odeh24/SRIP-ToT/touch_glove.png

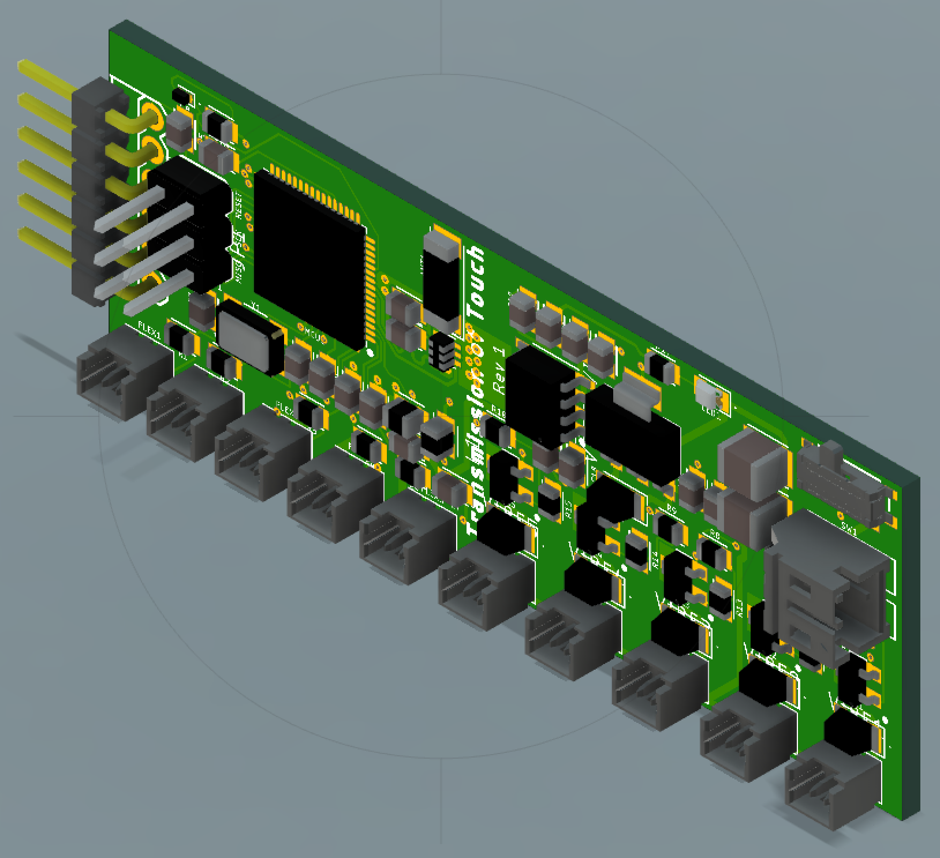
touch_glove.png
