odeh24/SRIP-ToT/mcad/TouchGlove v2.step

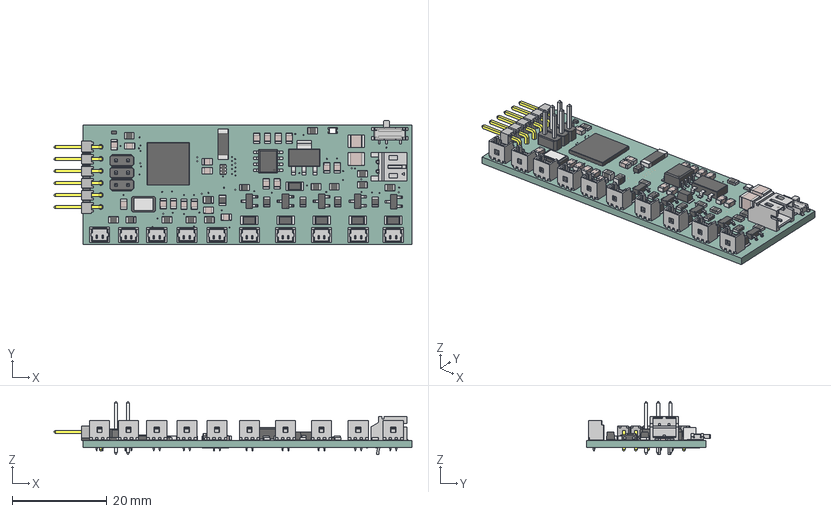
[picture p2: CAD file, 2018-08-09]
mcad/TouchGlove v2.step
75.6 x 26.2 x 11.3 mm
Board
2.45GHz
Dual TH withbump format x 3
50/100
1uF/25V x 19
100uF/10V x 2
1A/50V x 6
150mA/75V
10K x 5
_TSW-106-08-T-S-RA_body
_T-1S6-08-TSW-1-08-6-RA-S
base
cover
housing
marking x 2
base_2
7.4V
ATMEGA128RFA1
SI2302CDS 2.9A/20V x 5
2PT_GND_TIE x 2
300mA/4V
1A/3.3V
TL1963A-33 1.5A/3.3V
16 MHz
Molex VERT 1.25mm pitch x 5
PIB_LOGO_10MM
10uH x 2
