odeh24/SRIP-ToT/Eagle Schematics/RobotArm.brd

## EAGLE design Eagle Schematics/RobotArm.brd (2018-08-07)

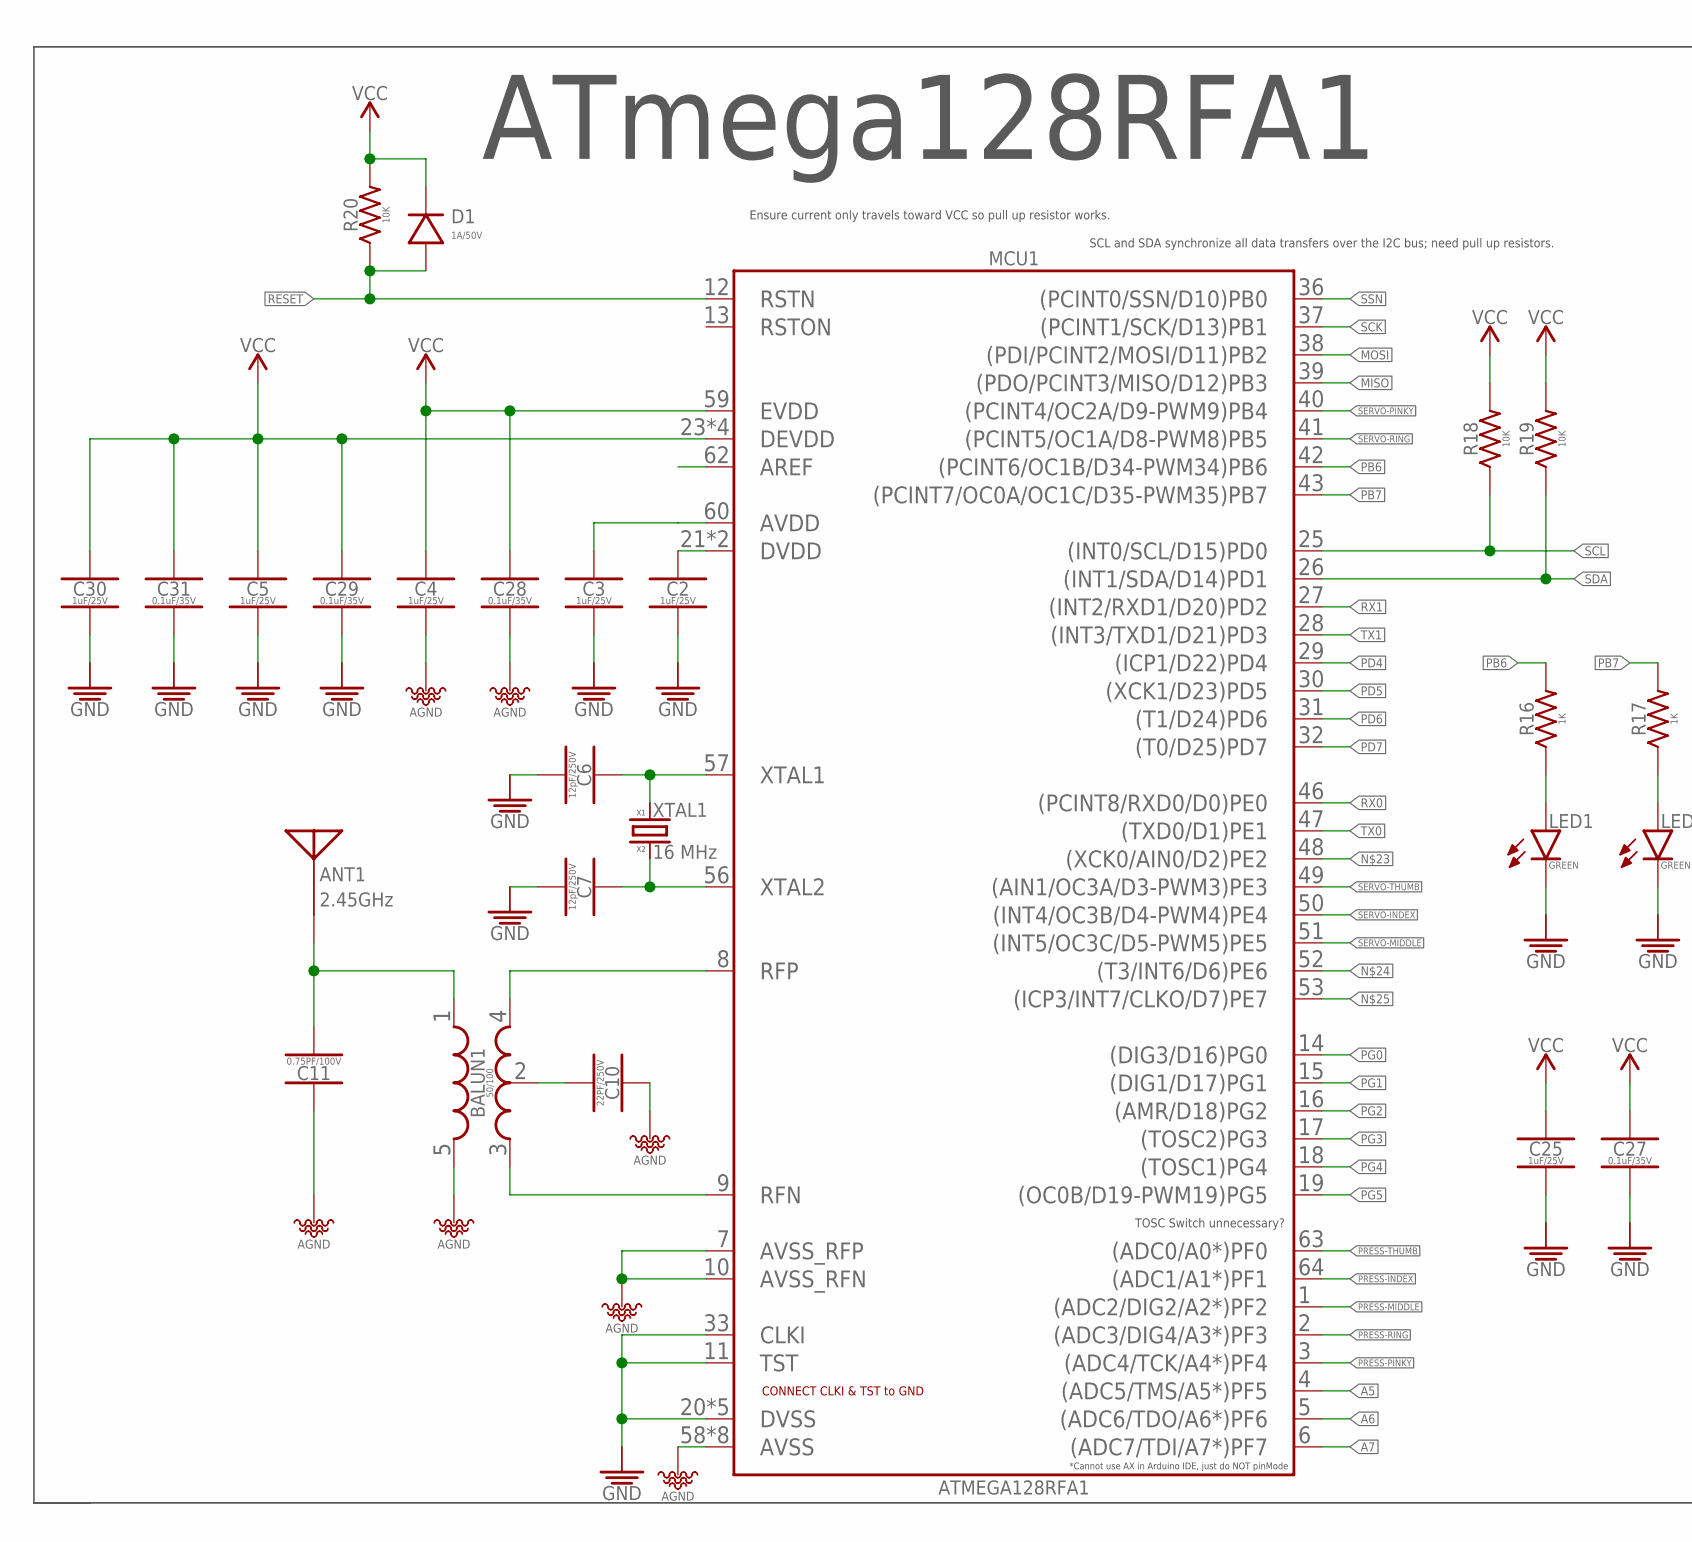
[picture p3: schematic RobotArm.sch, part in row 1, column 1]

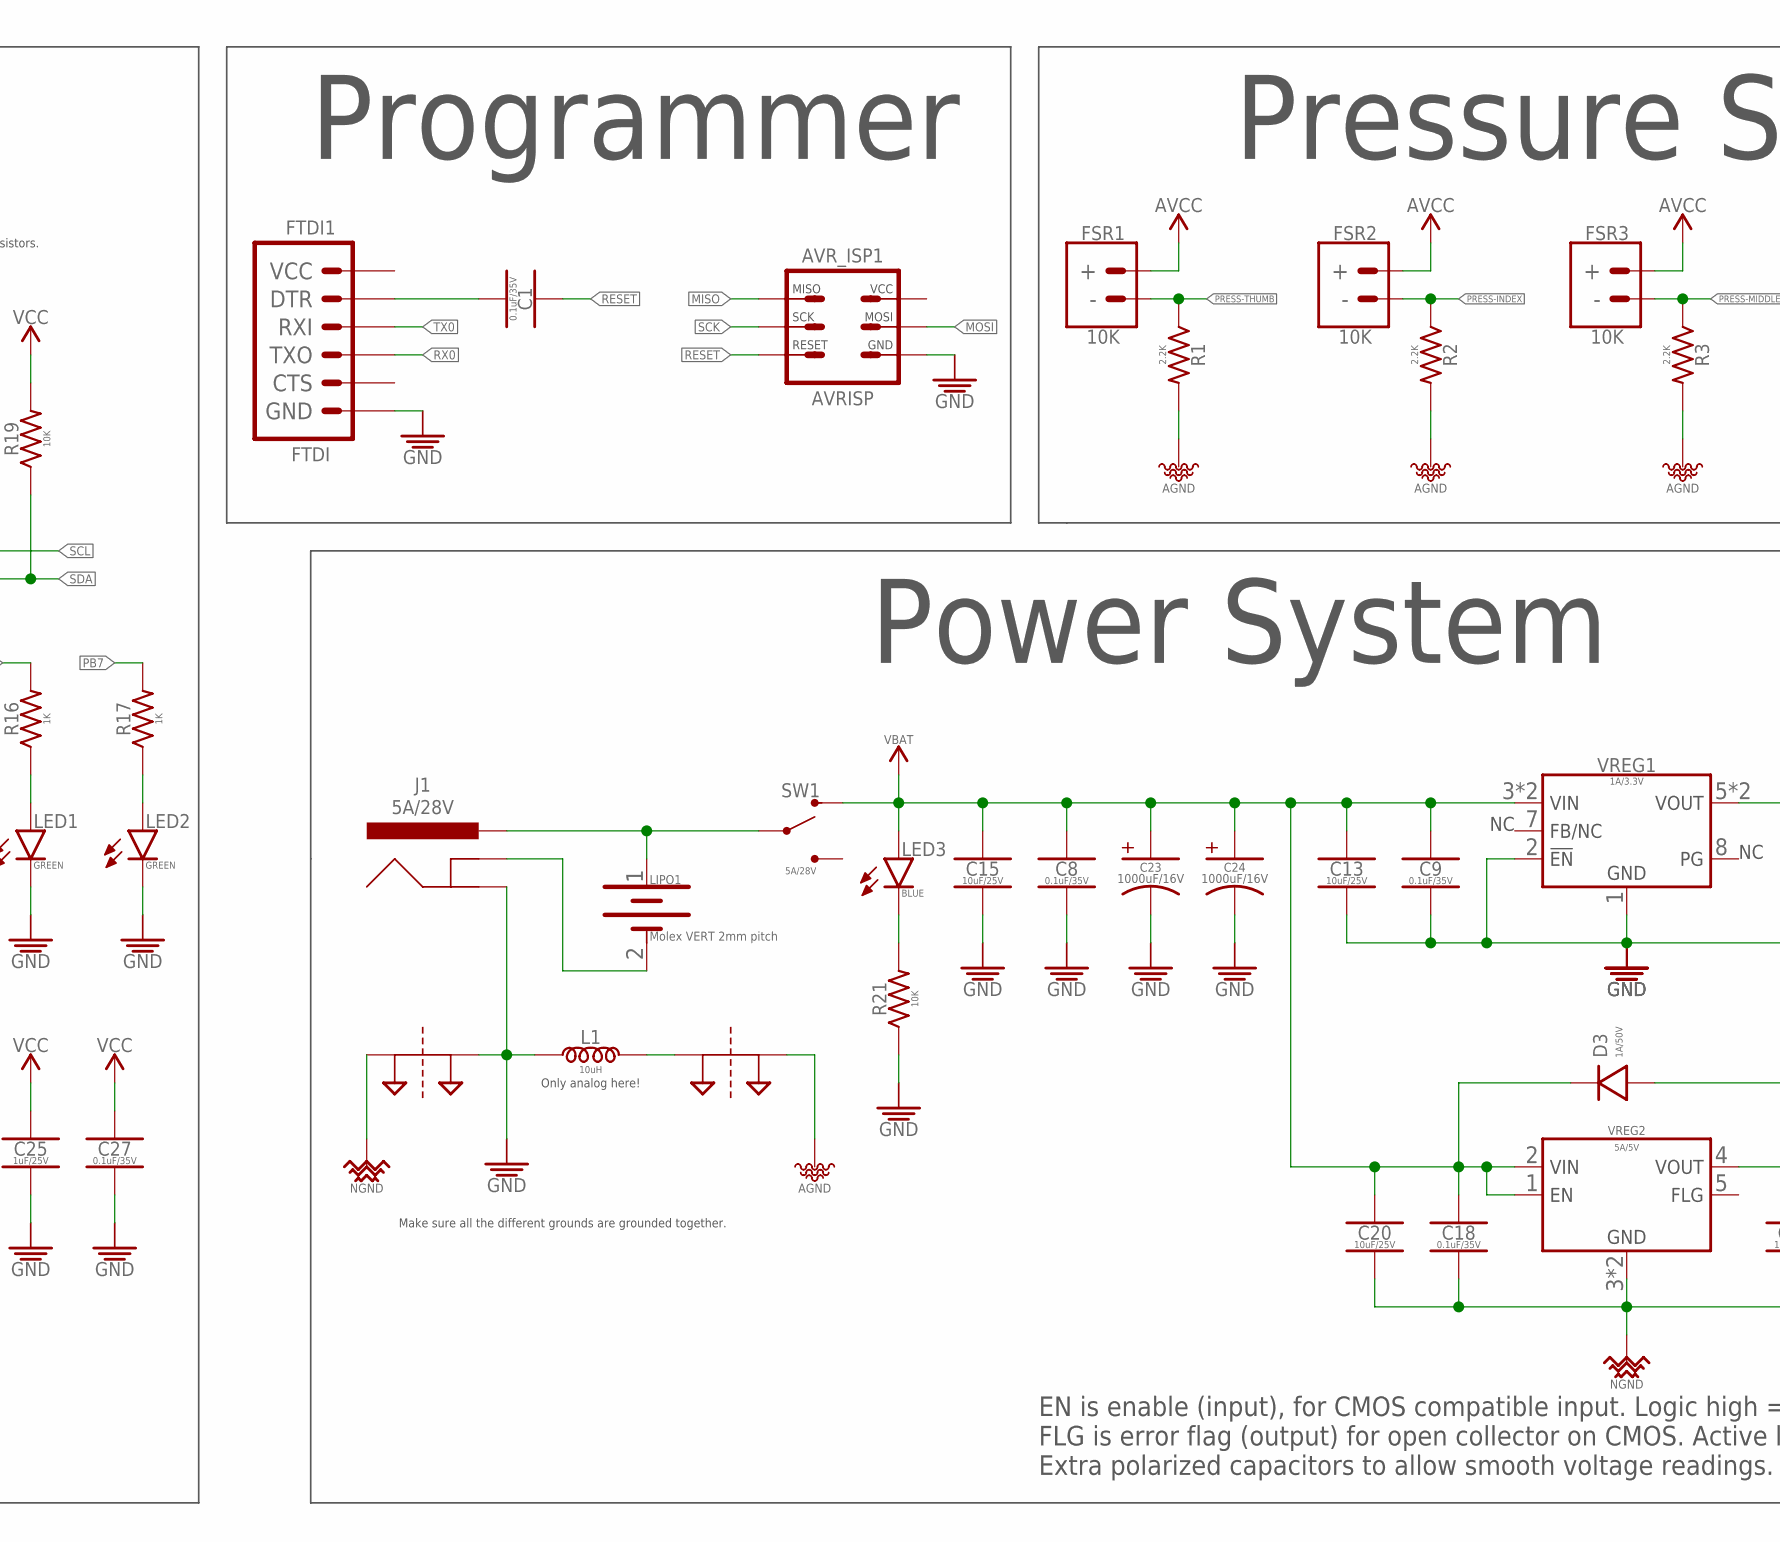
[picture p4: schematic RobotArm.sch, part in row 1, column 2]

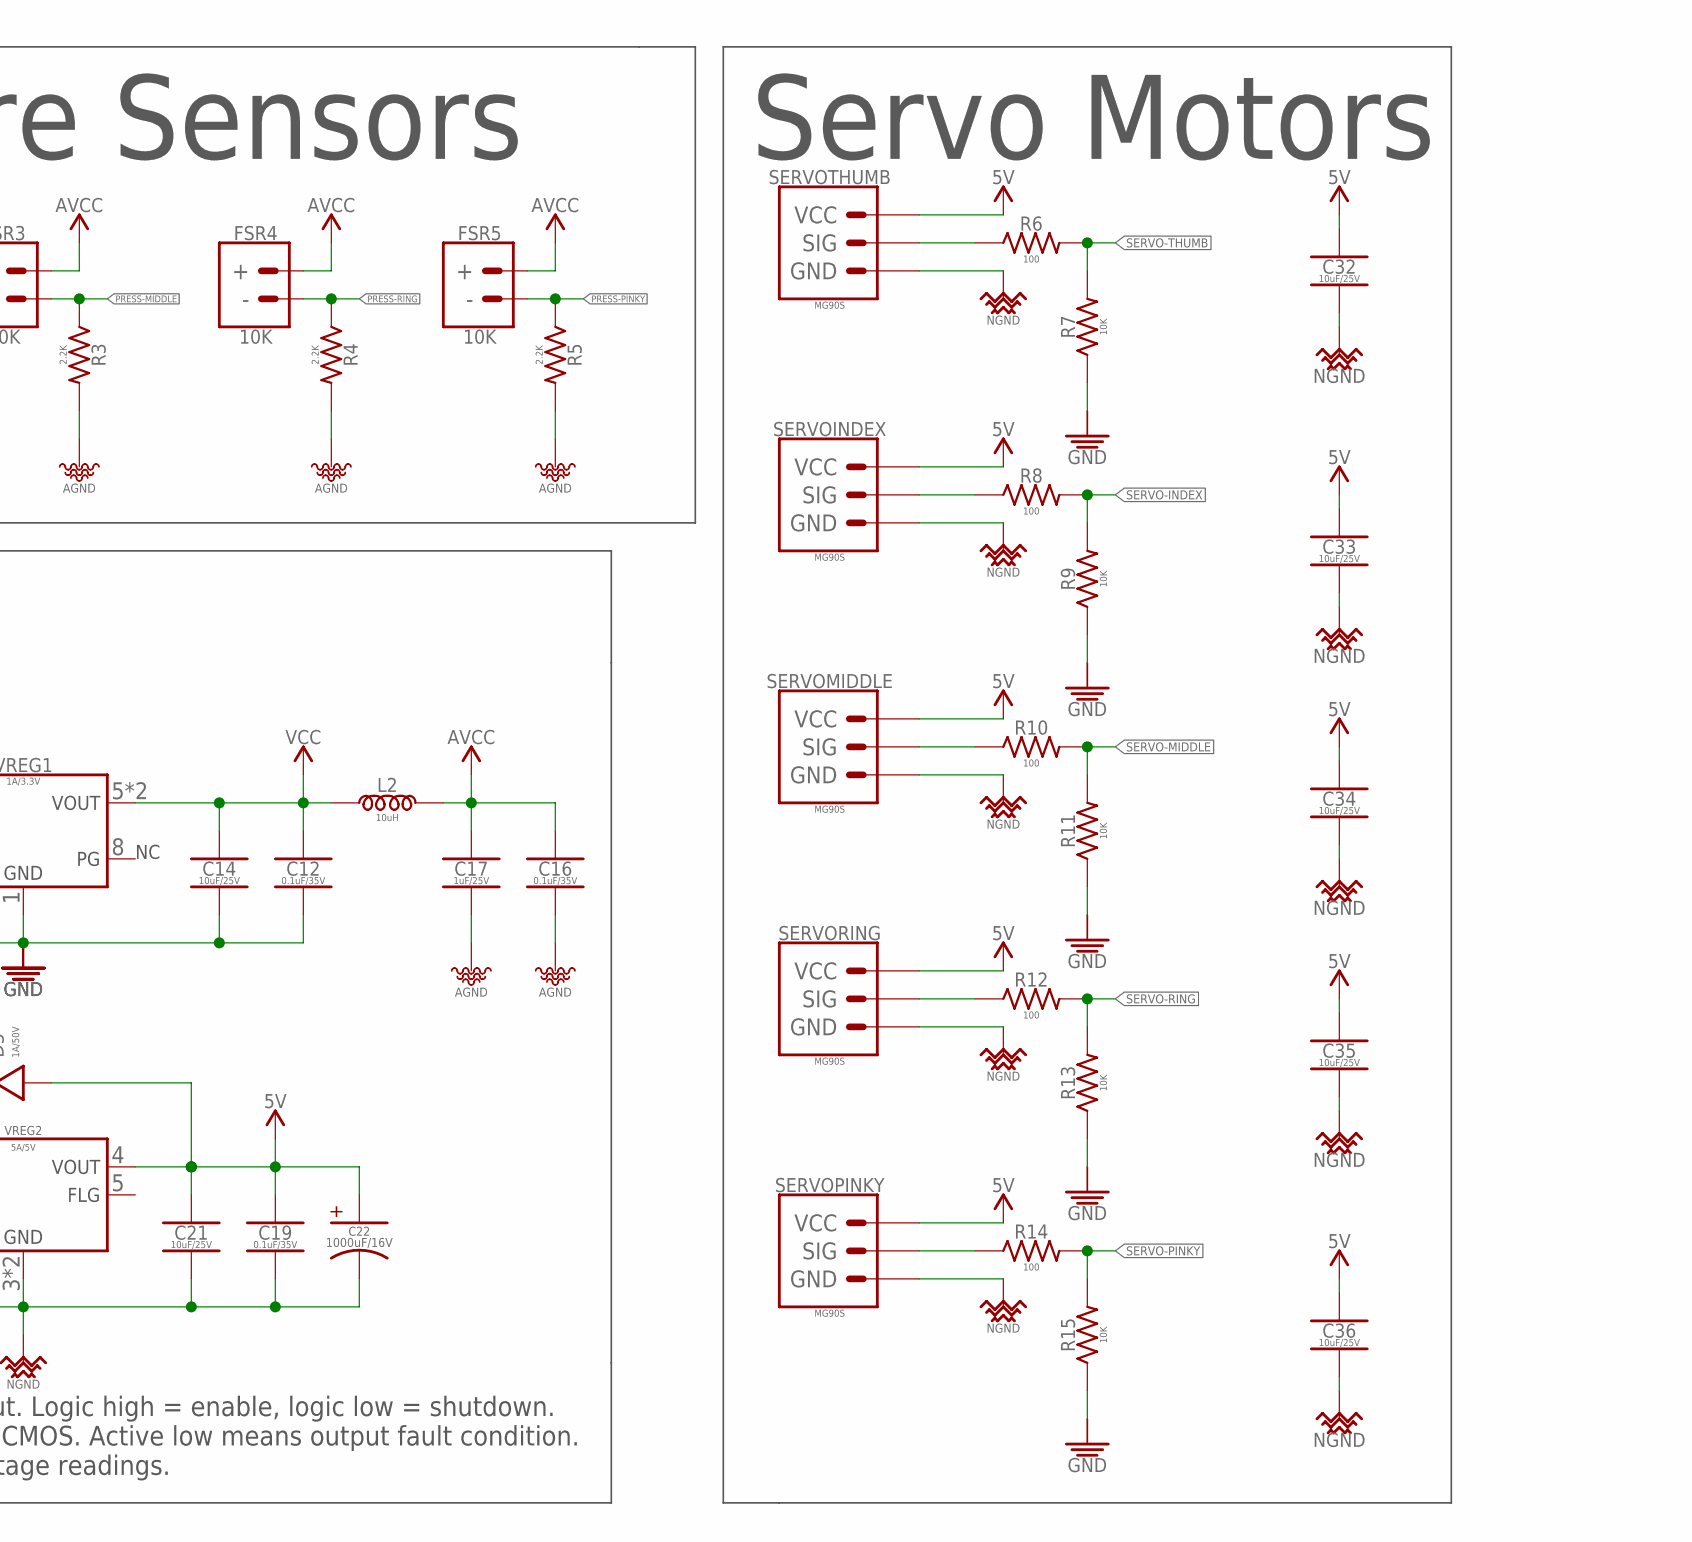
[picture p5: schematic RobotArm.sch, part in row 1, column 3]

Parts:
ANT1: 2.45GHz; ANTC6522X100
AVR_ISP1: AVRISP; 2X3-NS
BALUN1: 50/100; RESCAXE65P200X125X95-6
C1, C8, C9, C12, C16, C18, C19, C27, C28, C29, C31: 0.1uF/35V; CAPC2012X95_SMD-0805
C2, C3, C4, C5, C17, C25, C30: 1uF/25V; CAPC2012X95_SMD-0805
C6, C7: 12pF/250V; CAPC2012X95_SMD-0805
C10: 22PF/250V; _CER_SMD-805
C11: 0.75PF/100V; _CER_SMD-805
C13, C14, C15, C20, C21, C32, C33, C34, C35, C36: 10uF/25V; CAPC2012X95_SMD-0805
C22, C23, C24: 1000uF/16V; _AE_PTH_DIA8-LS3.5-H21.50
D1, D3: 1A/50V; SODFL3516X170
FSR1, FSR2, FSR3, FSR4, FSR5: 10K; _MOLEX-0530470210_VERT_PITCH-1.25MM
FTDI1: FTDI; FTDI_BASIC-6PIN-MALE-RA
J1: 5A/28V; POWER_JACK_PTH_ID2.1MM-OD5.5MM
L1, L2: 10uH; _SMD-805
LED1, LED2: GREEN; LEDC2012X120_LED-0805
LED3: BLUE; LEDC2012X120_LED-0805
LIPO1: Molex VERT 2mm pitch; _MOLEX-89400_VERT_PITCH-2MM
MCU1: ATMEGA128RFA1; QFN50P900X900X90-64
NET_BRIDGE1, NET_BRIDGE2: 2PT_GND_TIE
R1, R2, R3, R4, R5: 2.2K; RESC2012X60_SMD-0805
R6, R8, R10, R12, R14: 100; RESC2012X60_SMD-0805
R7, R9, R11, R13, R15, R18, R19, R20, R21: 10K; RESC2012X60_SMD-0805
R16, R17: 1K; RESC2012X60_SMD-0805
SERVOINDEX: MG90S; 1X03-VERT-MALE
SERVOMIDDLE: MG90S; 1X03-VERT-MALE
SERVOPINKY: MG90S; 1X03-VERT-MALE
SERVORING: MG90S; 1X03-VERT-MALE
SERVOTHUMB: MG90S; 1X03-VERT-MALE
SW1: 5A/28V; SW_TOGGLE_SPDT_5A-28V_13L-7W
VREG1: 1A/3.3V; SOIC127P600X265-8
VREG2: 5A/5V; TO170P1363X457-6
XTAL1: 16 MHz; OSCCC500X320X110

Connections:
5V: C19.1, C21.1, C22.+ (A), C32.1, C33.1, C34.1, C35.1, C36.1, D3.A, SERVOINDEX.VCC, SERVOMIDDLE.VCC, SERVOPINKY.VCC, SERVORING.VCC, SERVOTHUMB.VCC, VREG2.4 (VOUT)
+: J1.PWR, LIPO1.1 (+), SW1.P
-: J1.GND@1 (GND), LIPO1.2 (-)
A5: MCU1.4 ((ADC5/TMS/A5*)PF5)
A6: MCU1.5 ((ADC6/TDO/A6*)PF6)
A7: MCU1.6 ((ADC7/TDI/A7*)PF7)
AGND: BALUN1.5 (GND), C4.2, C10.1, C11.1, C16.2, C17.2, C28.2, MCU1.7 (AVSS_RFP), MCU1.10 (AVSS_RFN), MCU1.58 (AVSS), MCU1.61 (AVSS), MCU1.EP (AVSS), MCU1.P$1 (AVSS), MCU1.P$2 (AVSS), MCU1.P$3 (AVSS), MCU1.P$4 (AVSS), MCU1.P$5 (AVSS), NET_BRIDGE2.P$2, R1.2, R2.2, R3.2, R4.2, R5.2
AVCC: C16.1, C17.1, L2.2
GND: AVR_ISP1.GND, C2.2, C3.2, C5.2, C6.2, C7.2, C8.2, C9.2, C12.2, C13.2, C14.2, C15.2, C23.- (K), C24.- (K), C25.2, C27.2, C29.2, C30.2, C31.2, FTDI1.GND, J1.GND@2 (GND), L1.1, LED1.K, LED2.K, MCU1.11 (TST), MCU1.20 (DVSS), MCU1.24 (DVSS), MCU1.33 (CLKI), MCU1.35 (DVSS), MCU1.45 (DVSS), MCU1.55 (DVSS), NET_BRIDGE1.P$2, R7.1, R9.1, R11.1, R13.1, R15.1, R21.1, VREG1.1 (GND), VREG1.2 (!EN)
MISO: AVR_ISP1.MISO, MCU1.39 ((PDO/PCINT3/MISO/D12)PB3)
MOSI: AVR_ISP1.MOSI, MCU1.38 ((PDI/PCINT2/MOSI/D11)PB2)
unnamed: R6.1, SERVOTHUMB.SIG
unnamed: LED1.A, R16.1
unnamed: R8.1, SERVOINDEX.SIG
unnamed: R10.1, SERVOMIDDLE.SIG
unnamed: R12.1, SERVORING.SIG
unnamed: R14.1, SERVOPINKY.SIG
unnamed: LED2.A, R17.1
unnamed: C6.1, MCU1.57 (XTAL1), XTAL1.1 (XTAL1)
unnamed: C7.1, MCU1.56 (XTAL2), XTAL1.3 (XTAL2)
unnamed: C1.2, FTDI1.DTR
unnamed: BALUN1.4 (OUT2), MCU1.8 (RFP)
unnamed: BALUN1.3 (OUT1), MCU1.9 (RFN)
unnamed: C3.1, MCU1.60 (AVDD)
unnamed: C2.1, MCU1.21 (DVDD), MCU1.22 (DVDD)
unnamed: BALUN1.2 (GND), C10.2
unnamed: ANT1.1, BALUN1.1 (IN), C11.2
unnamed: L1.2, NET_BRIDGE2.P$1
unnamed: LED3.K, R21.2
NGND: C18.2, C19.2, C20.2, C21.2, C22.- (K), C32.2, C33.2, C34.2, C35.2, C36.2, NET_BRIDGE1.P$1, SERVOINDEX.GND, SERVOMIDDLE.GND, SERVOPINKY.GND, SERVORING.GND, SERVOTHUMB.GND, VREG2.3 (GND), VREG2.6 (GND)
PB6: MCU1.42 ((PCINT6/OC1B/D34-PWM34)PB6), R16.2
PB7: MCU1.43 ((PCINT7/OC0A/OC1C/D35-PWM35)PB7), R17.2
PD4: MCU1.29 ((ICP1/D22)PD4)
PD5: MCU1.30 ((XCK1/D23)PD5)
PD6: MCU1.31 ((T1/D24)PD6)
PD7: MCU1.32 ((T0/D25)PD7)
PG0: MCU1.14 ((DIG3/D16)PG0)
PG1: MCU1.15 ((DIG1/D17)PG1)
PG2: MCU1.16 ((AMR/D18)PG2)
PG3: MCU1.17 ((TOSC2)PG3)
PG4: MCU1.18 ((TOSC1)PG4)
PG5: MCU1.19 ((OC0B/D19-PWM19)PG5)
PRESS-INDEX: FSR2.2 (-), MCU1.64 ((ADC1/A1*)PF1), R2.1
PRESS-MIDDLE: FSR3.2 (-), MCU1.1 ((ADC2/DIG2/A2*)PF2), R3.1
PRESS-PINKY: FSR5.2 (-), MCU1.3 ((ADC4/TCK/A4*)PF4), R5.1
PRESS-RING: FSR4.2 (-), MCU1.2 ((ADC3/DIG4/A3*)PF3), R4.1
PRESS-THUMB: FSR1.2 (-), MCU1.63 ((ADC0/A0*)PF0), R1.1
RESET: AVR_ISP1.RESET, C1.1, D1.A, MCU1.12 (RSTN), R20.1
RX0: FTDI1.TXO, MCU1.46 ((PCINT8/RXD0/D0)PE0)
RX1: MCU1.27 ((INT2/RXD1/D20)PD2)
SCK: AVR_ISP1.SCK, MCU1.37 ((PCINT1/SCK/D13)PB1)
SCL: MCU1.25 ((INT0/SCL/D15)PD0), R18.1
SDA: MCU1.26 ((INT1/SDA/D14)PD1), R19.1
SERVO-INDEX: MCU1.50 ((INT4/OC3B/D4-PWM4)PE4), R8.2, R9.2
SERVO-MIDDLE: MCU1.51 ((INT5/OC3C/D5-PWM5)PE5), R10.2, R11.2
SERVO-PINKY: MCU1.40 ((PCINT4/OC2A/D9-PWM9)PB4), R14.2, R15.2
SERVO-RING: MCU1.41 ((PCINT5/OC1A/D8-PWM8)PB5), R12.2, R13.2
SERVO-THUMB: MCU1.49 ((AIN1/OC3A/D3-PWM3)PE3), R6.2, R7.2
SSN: MCU1.36 ((PCINT0/SSN/D10)PB0)
TX0: FTDI1.RXI, MCU1.47 ((TXD0/D1)PE1)
TX1: MCU1.28 ((INT3/TXD1/D21)PD3)
VBAT: C8.1, C9.1, C13.1, C15.1, C18.1, C20.1, C23.+ (A), C24.+ (A), D3.K, LED3.A, SW1.S1, VREG1.3 (VIN), VREG1.4 (VIN), VREG2.1 (EN), VREG2.2 (VIN)
VCC: C4.1, C5.1, C12.1, C14.1, C25.1, C27.1, C28.1, C29.1, C30.1, C31.1, D1.K, FSR1.1 (+), FSR2.1 (+), FSR3.1 (+), FSR4.1 (+), FSR5.1 (+), L2.1, MCU1.23 (DEVDD), MCU1.34 (DEVDD), MCU1.44 (DEVDD), MCU1.54 (DEVDD), MCU1.59 (EVDD), R18.2, R19.2, R20.2, VREG1.5 (VOUT), VREG1.6 (VOUT)

Notes on the sheet:
ATmega128RFA1
Pressure Sensors
Power System
Programmer
Servo Motors
SCL and SDA synchronize all data transfers over the I2C bus; need pull up resistors.
TOSC Switch unnecessary?
Ensure current only travels toward VCC so pull up resistor works.
Make sure all the different grounds are grounded together.
Only analog here!
EN is enable (input), for CMOS compatible input. Logic high = enable, logic low = shutdown. FLG is error flag (output) for open collector on CMOS. Active low means output fault condition. Extra polarized capacitors to allow smooth voltage readings.

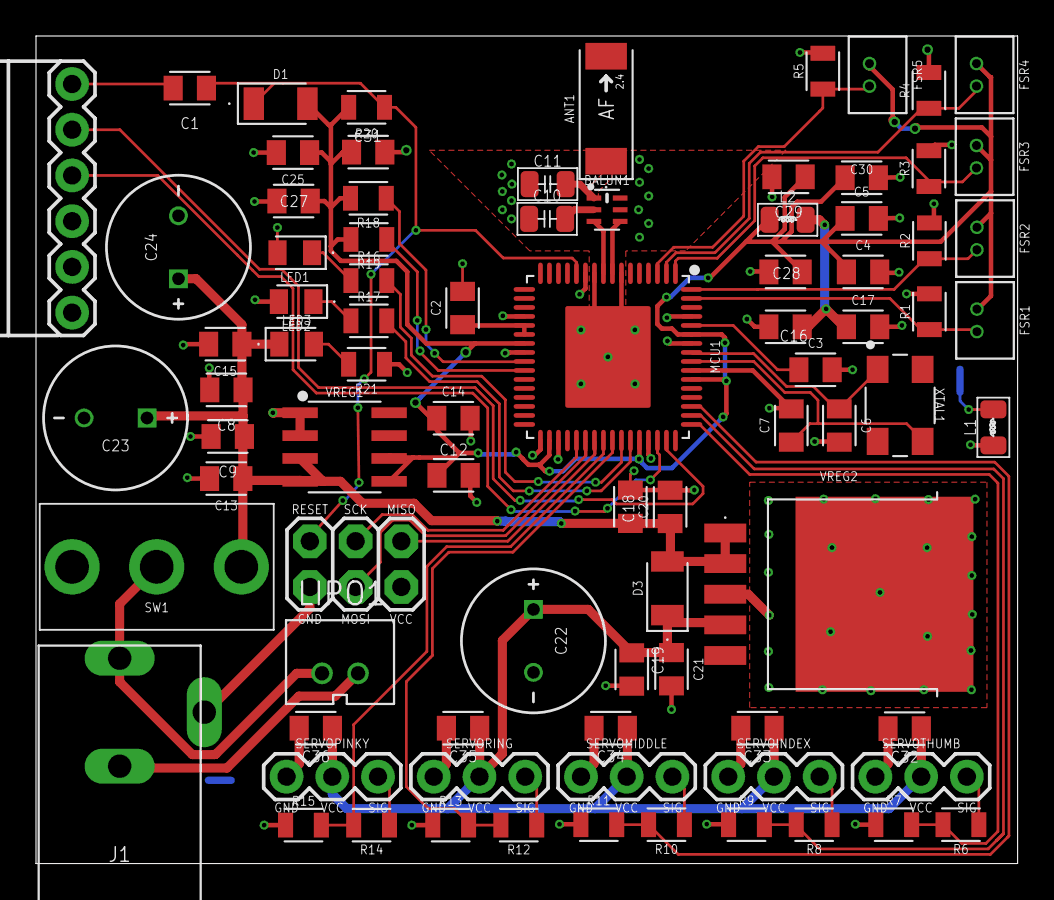
[picture p6: board RobotArm.brd from above]

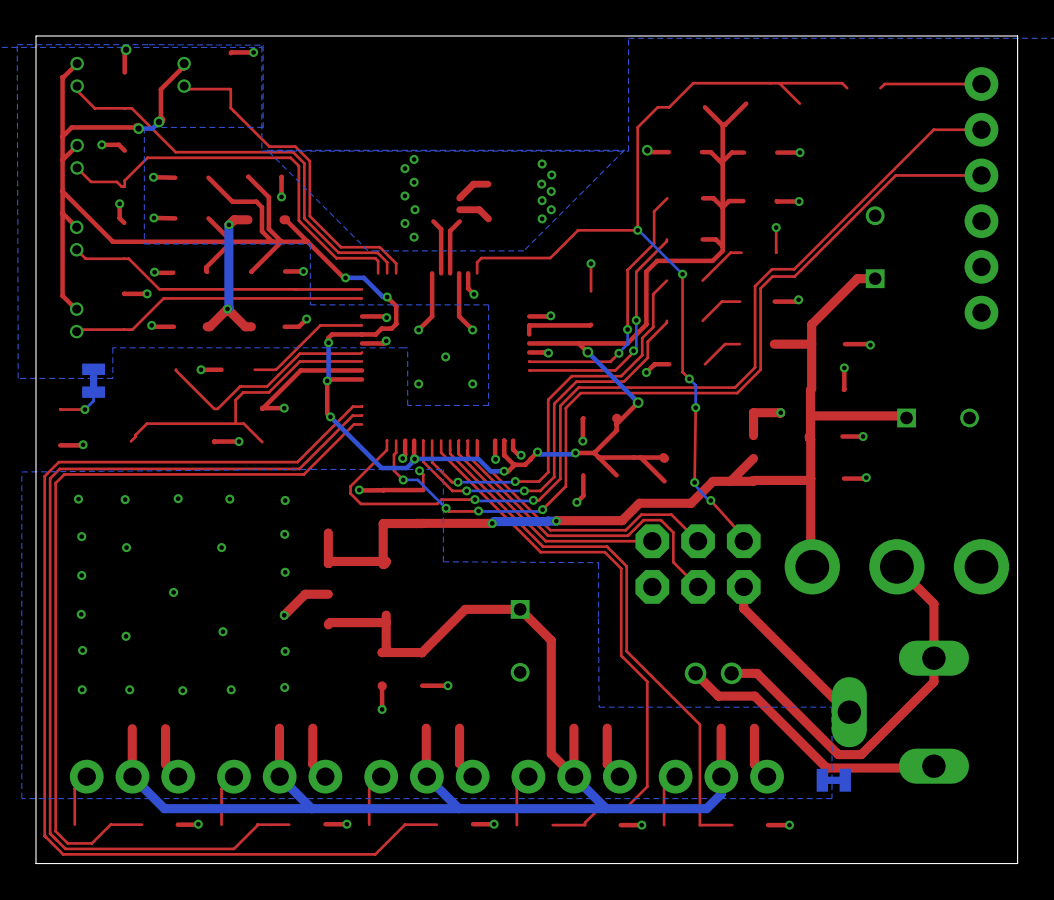
[picture p7: board RobotArm.brd from below]

Board: 2 copper layers, 54.5 x 46.0 mm, 86 parts (2 on the bottom side), 47 nets.
