odeh24/SRIP-ToT/Eagle /TouchGlove.brd

## EAGLE design Eagle /TouchGlove.brd (2018-08-09)

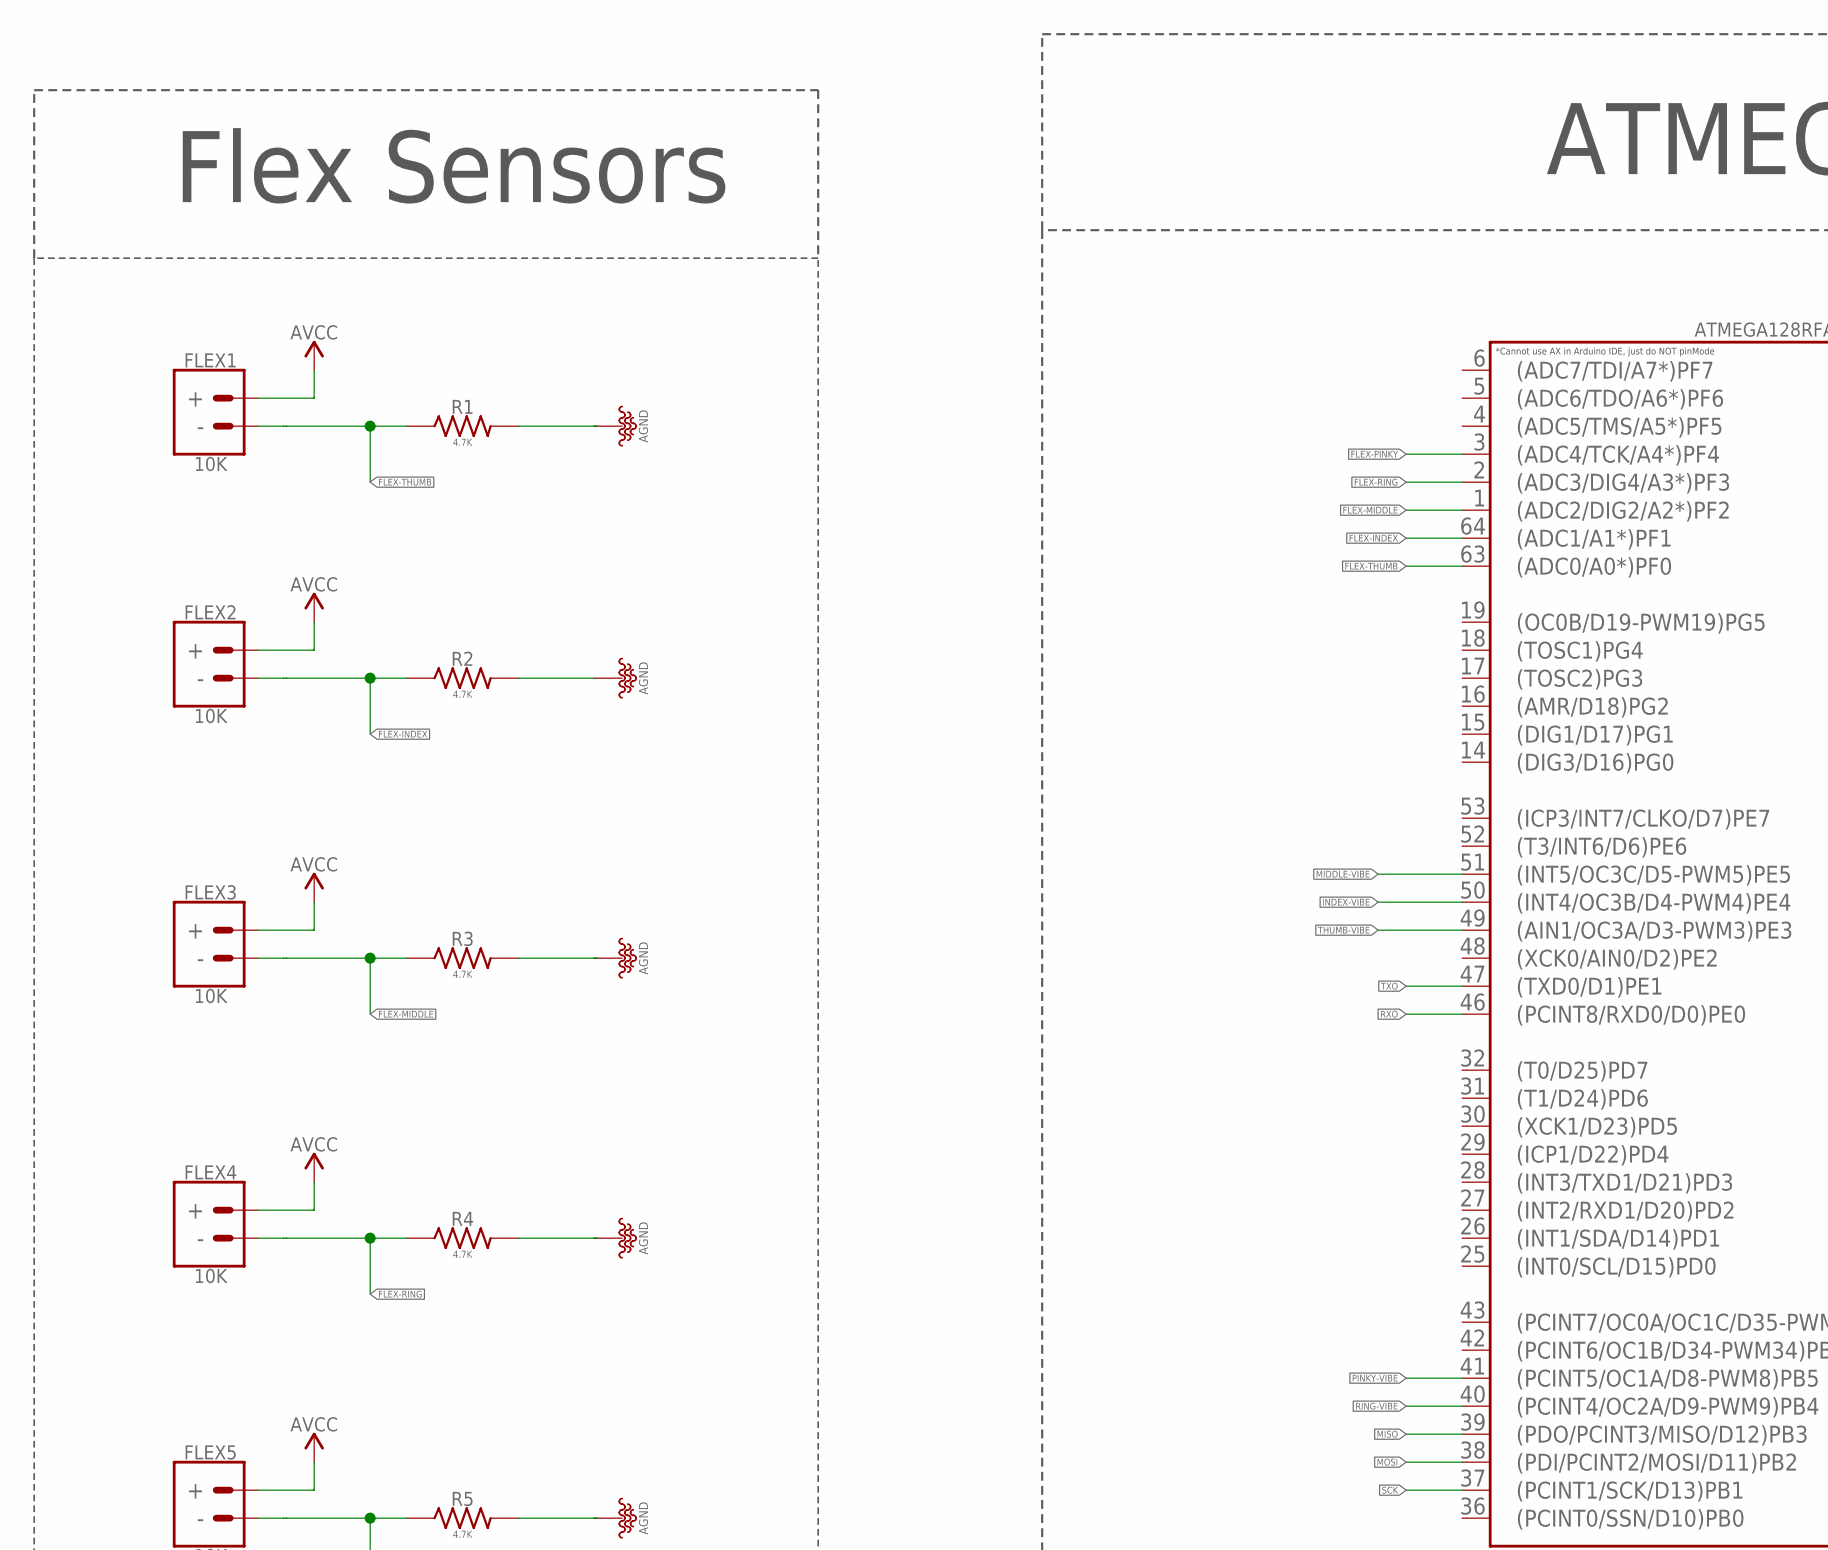
[picture p8: schematic TouchGlove.sch, part in row 1, column 1]

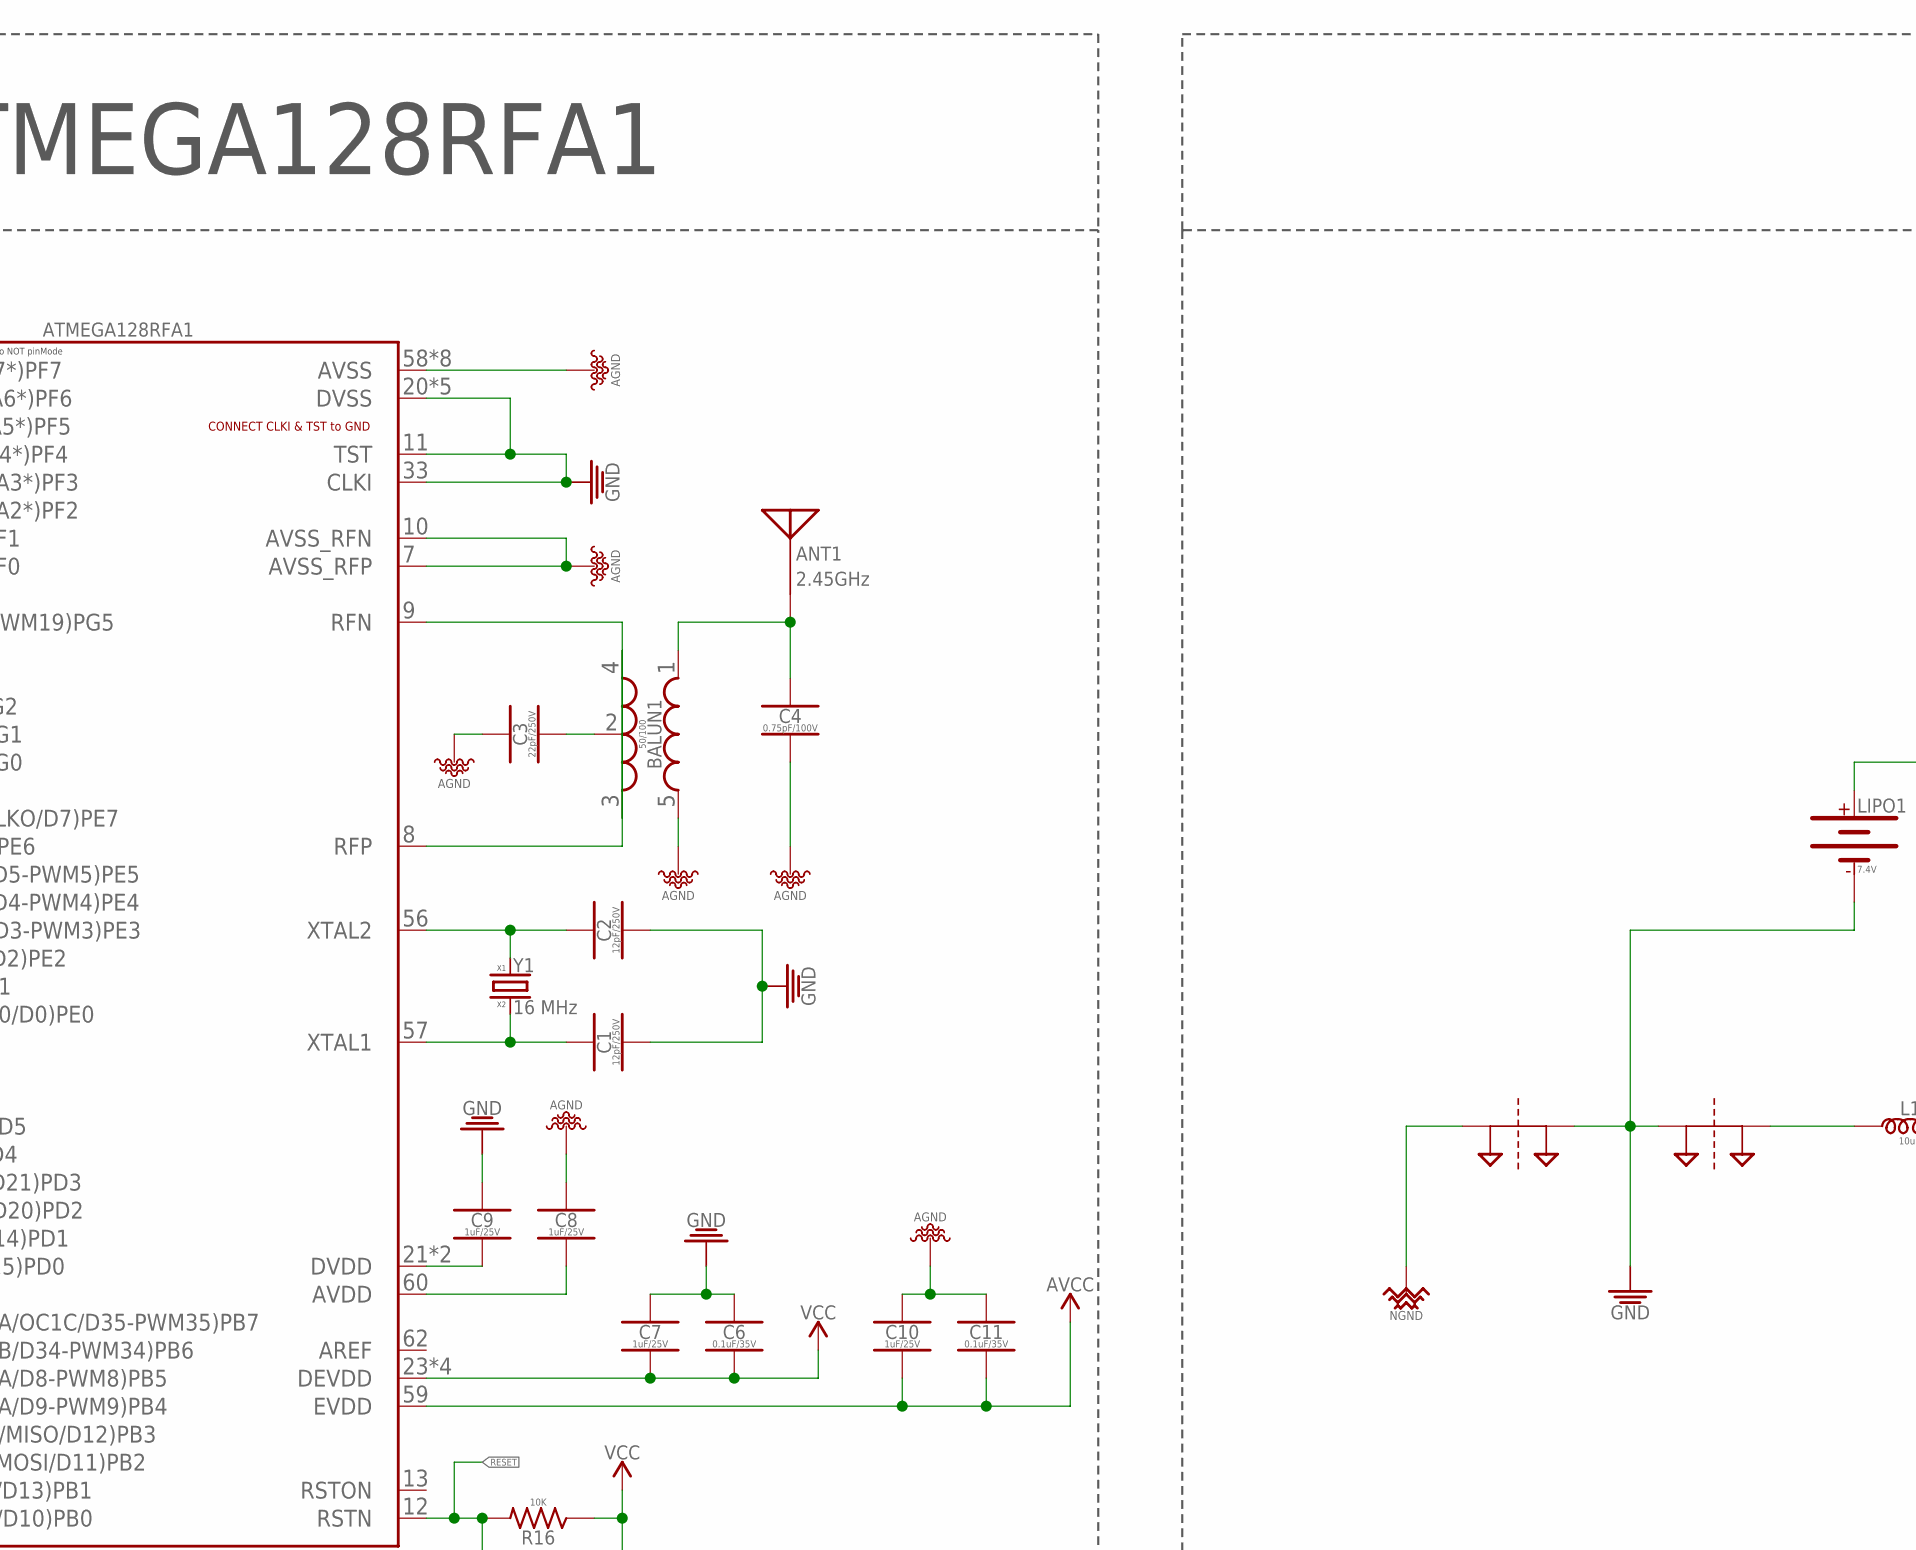
[picture p9: schematic TouchGlove.sch, part in row 1, column 2]

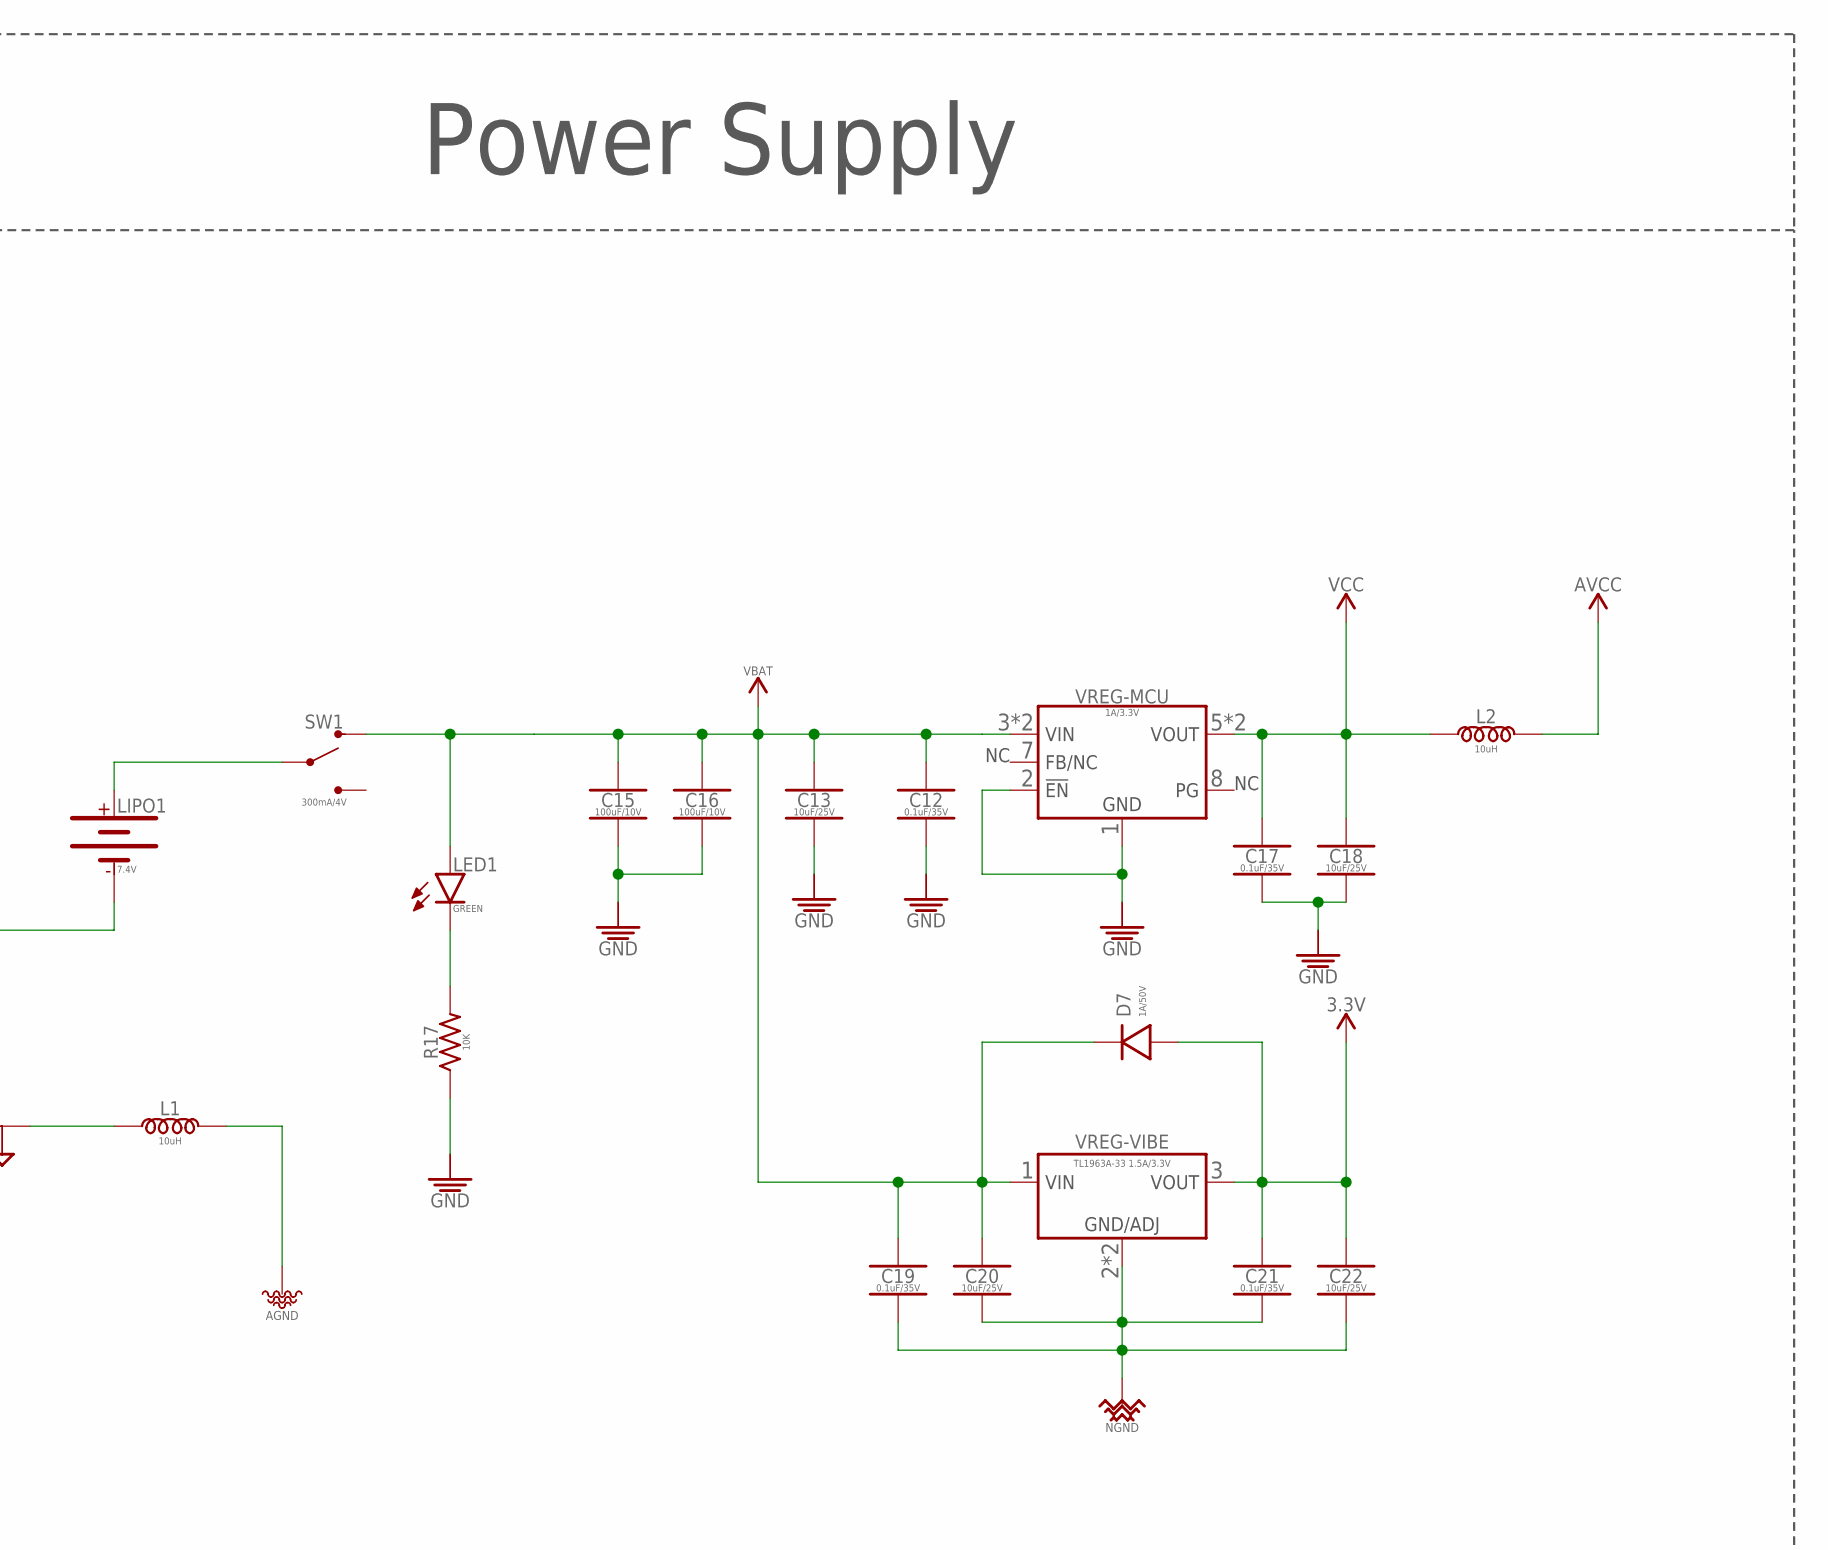
[picture p10: schematic TouchGlove.sch, part in row 1, column 3]

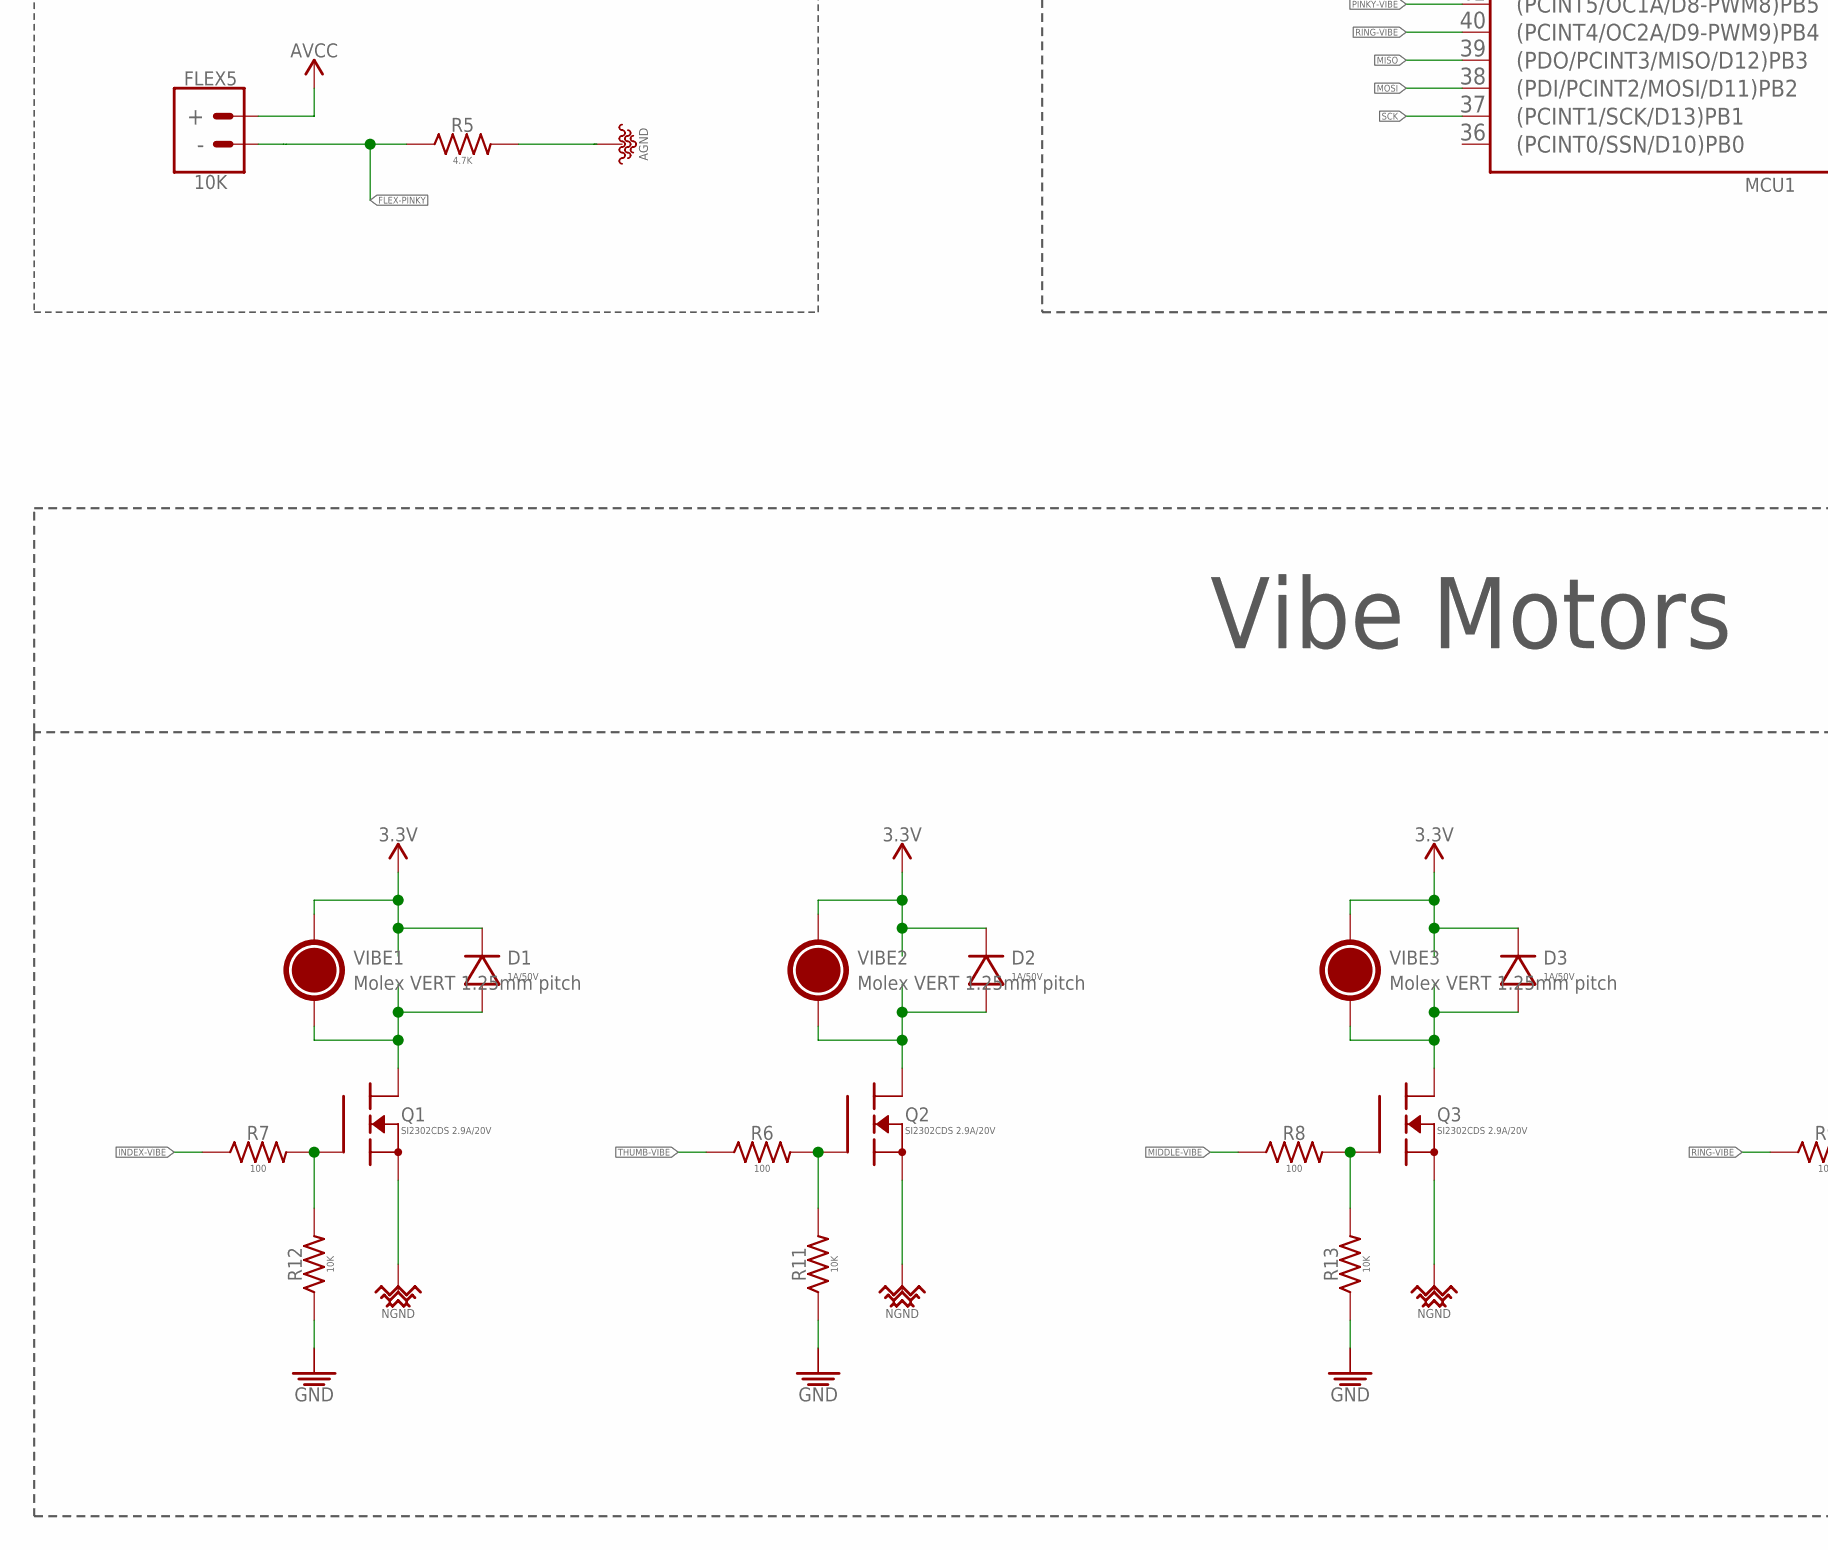
[picture p11: schematic TouchGlove.sch, part in row 2, column 1]

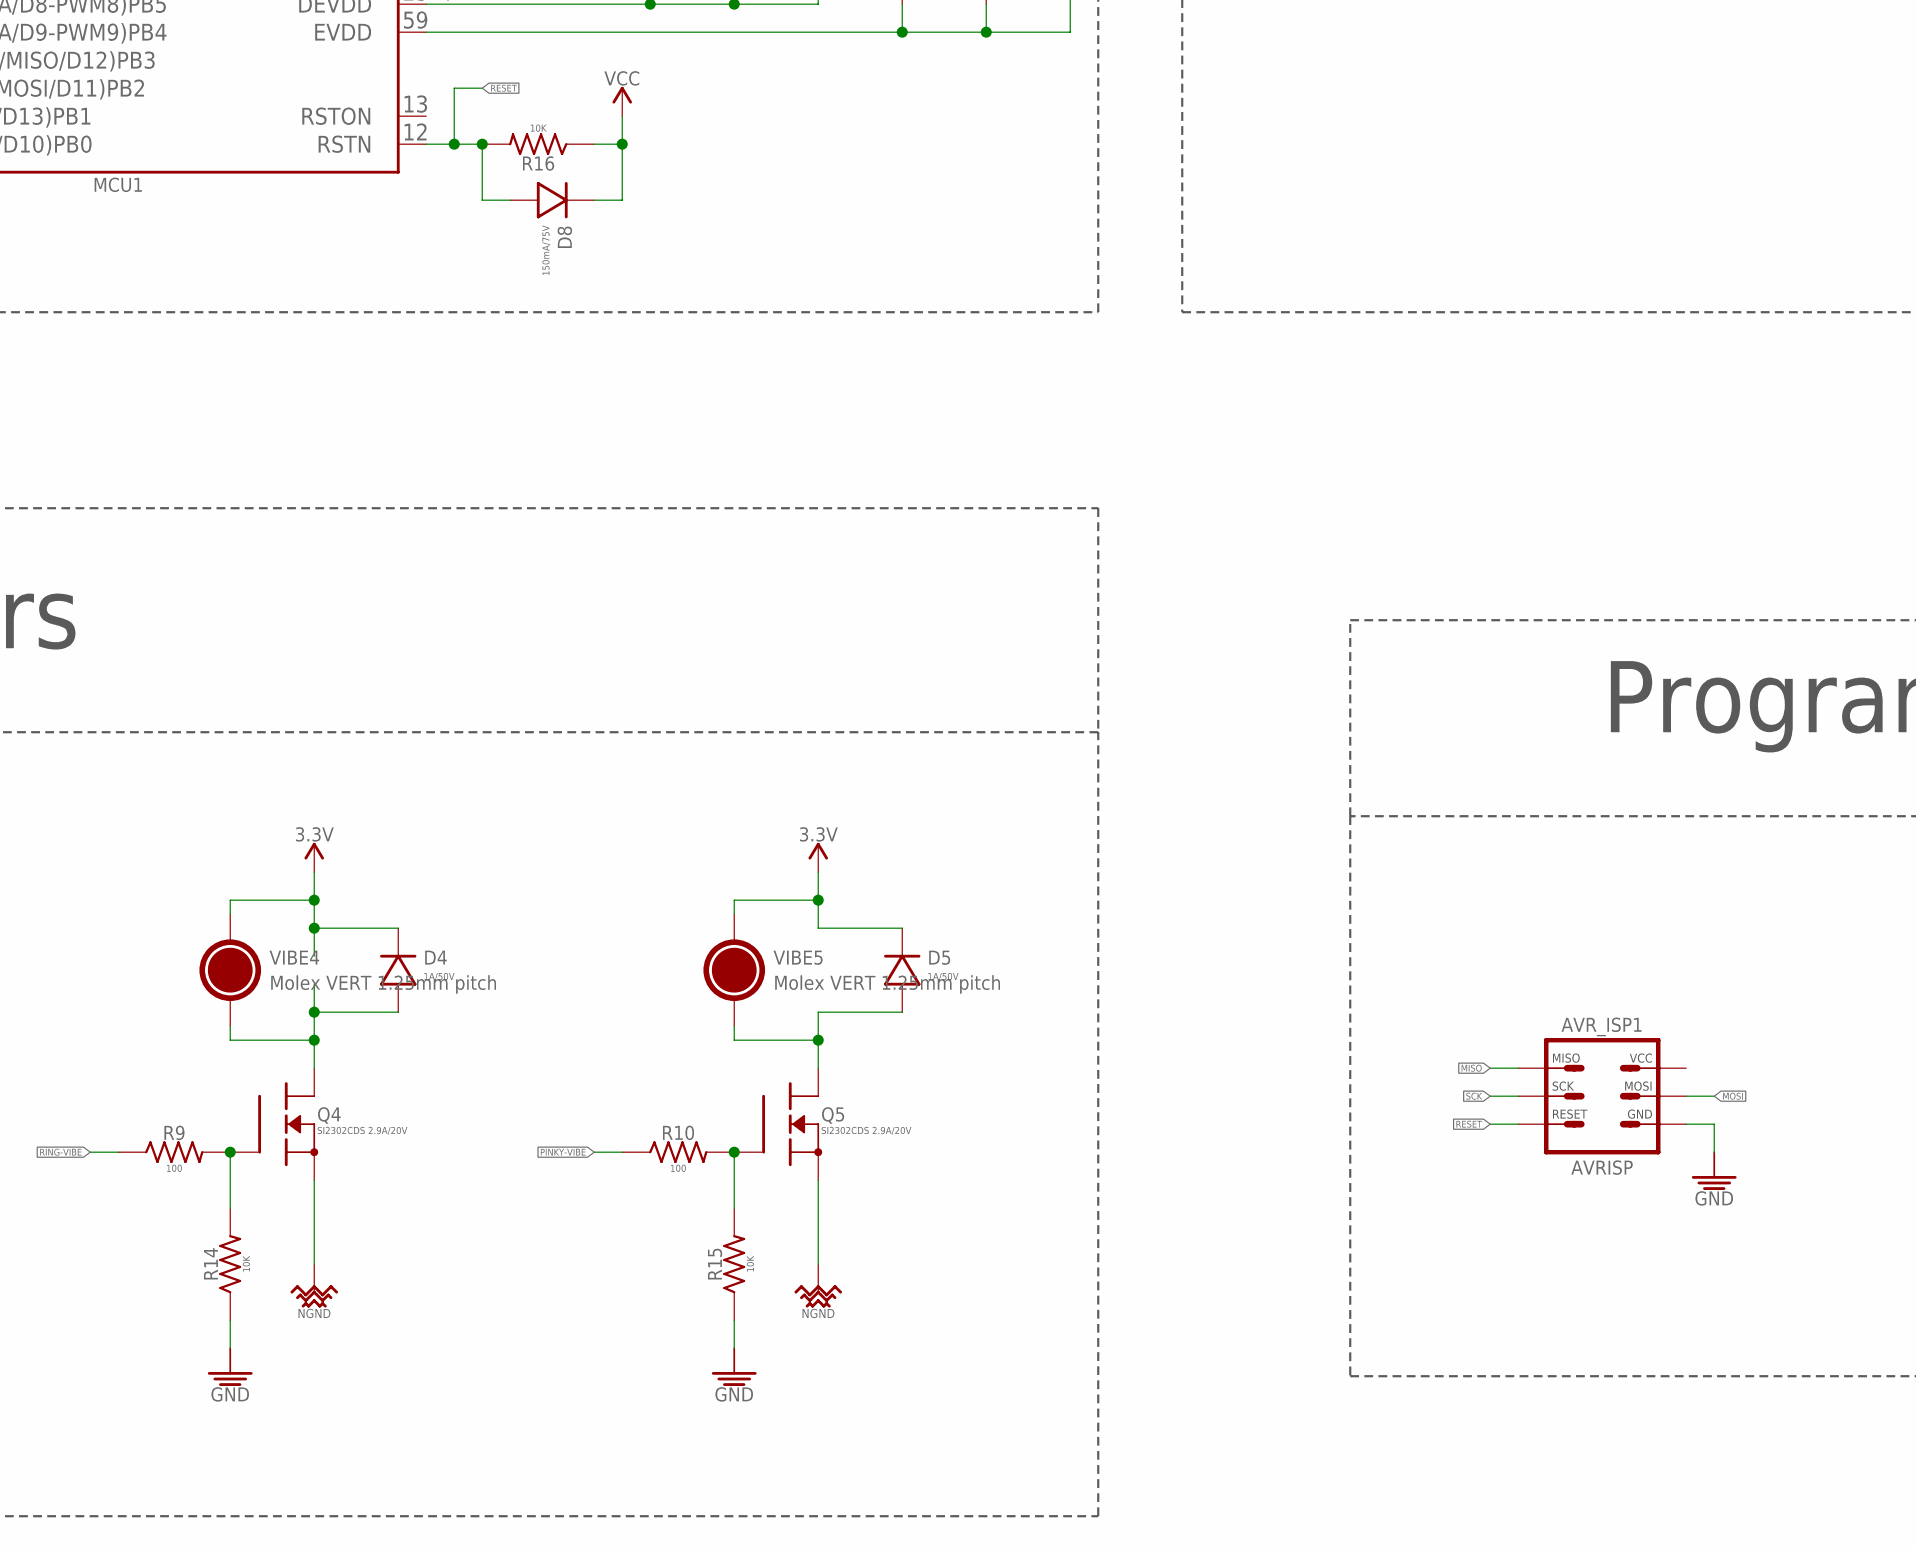
[picture p12: schematic TouchGlove.sch, part in row 2, column 2]

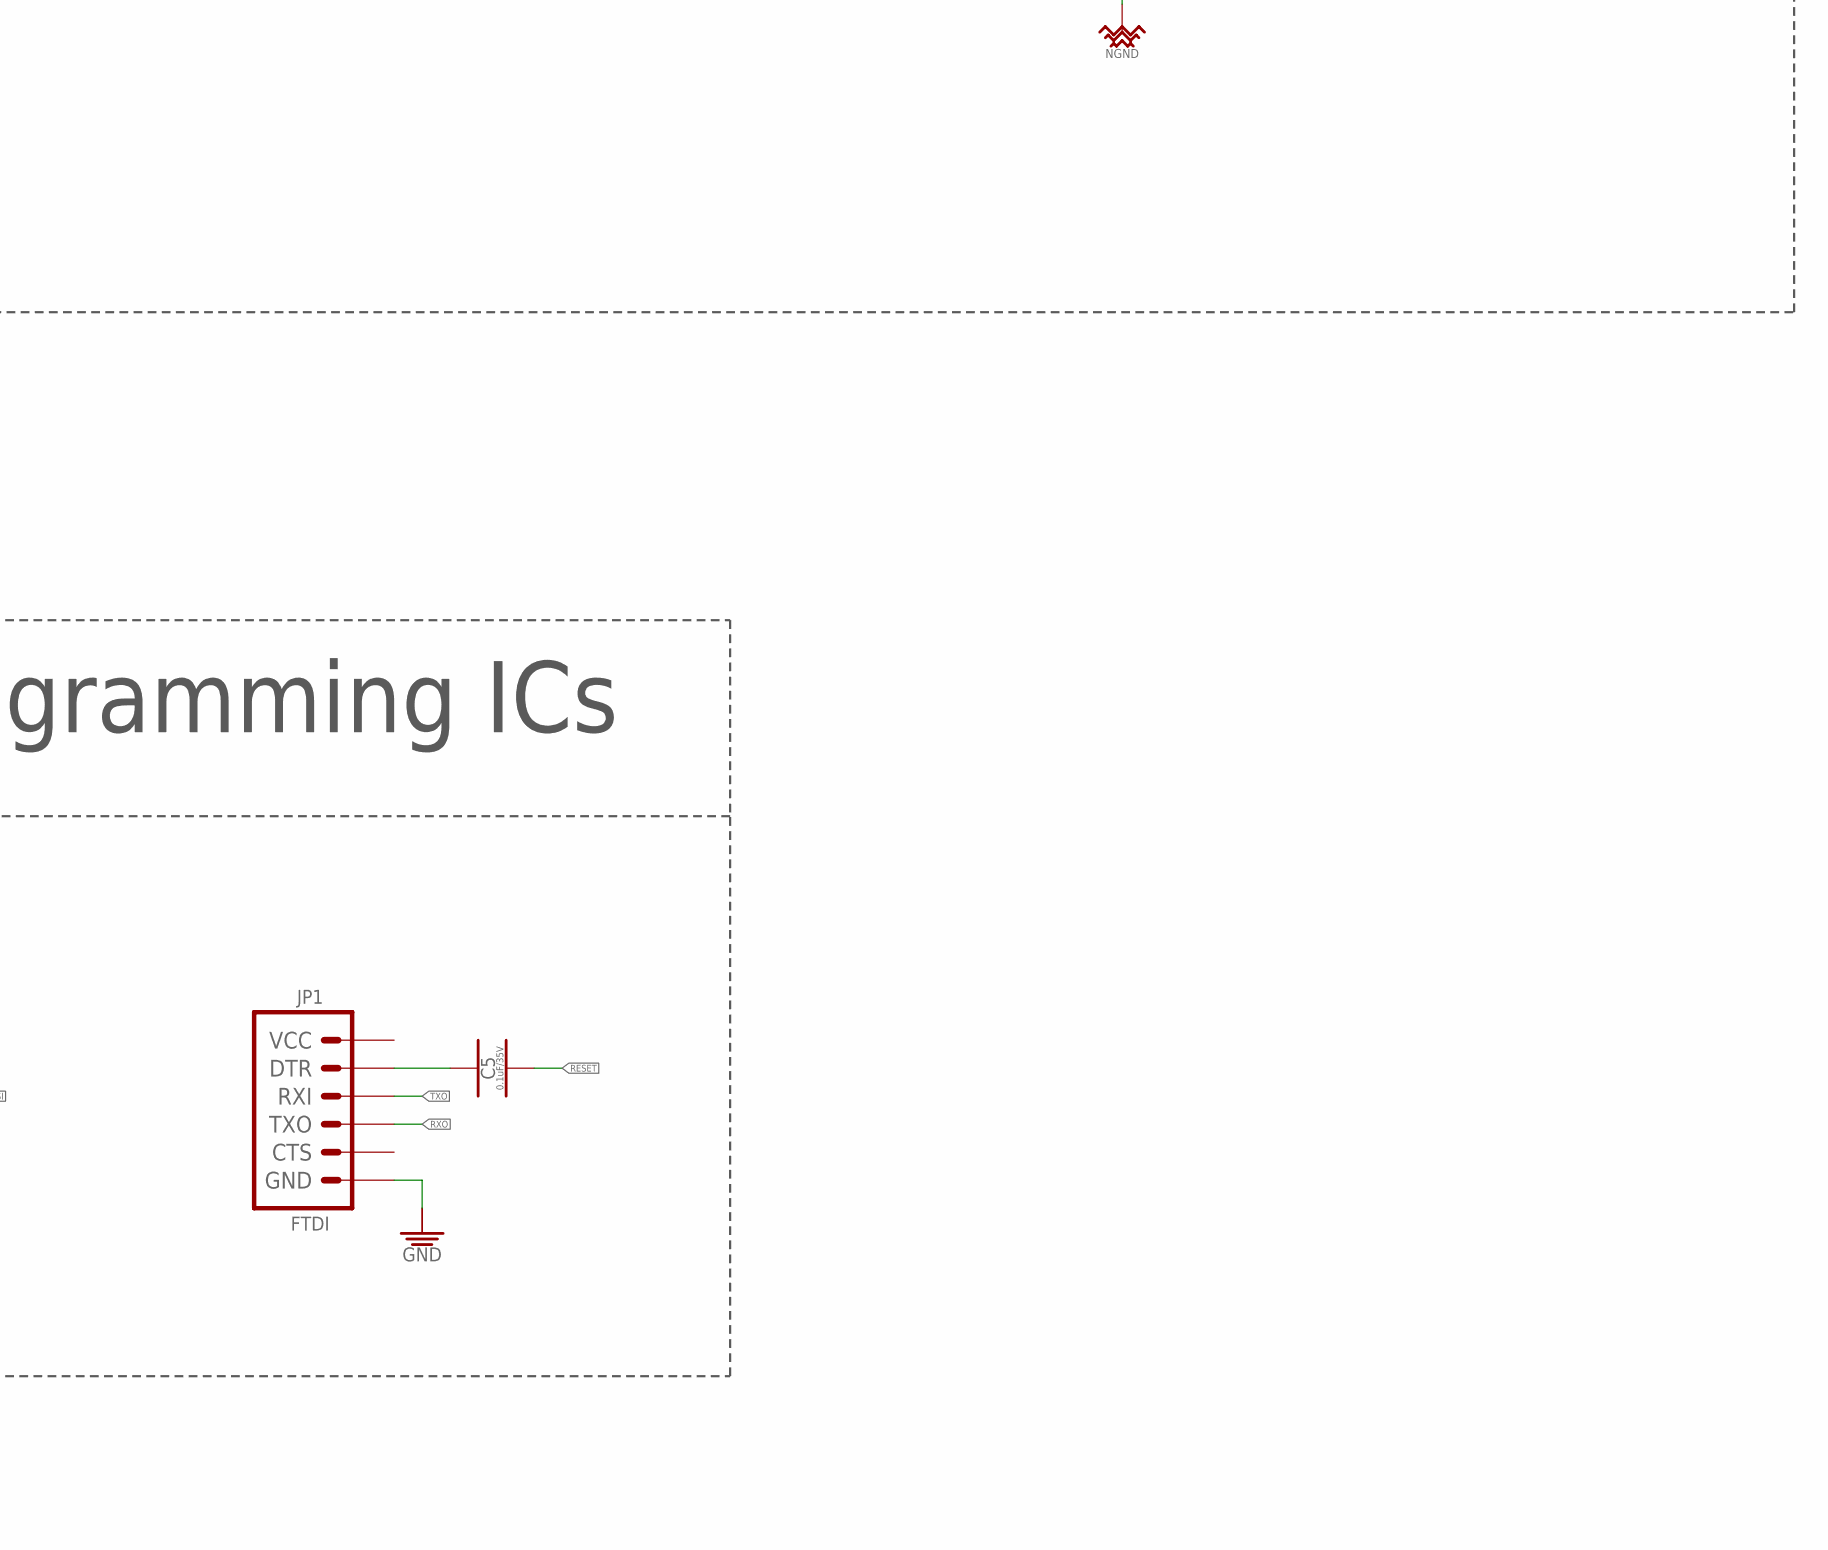
[picture p13: schematic TouchGlove.sch, part in row 2, column 3]

Parts:
ANT1: 2.45GHz; ANTC6522X100
AVR_ISP1: AVRISP; 2X3-NS
BALUN1: 50/100; RESCAXE65P200X125X95-6
C1, C2: 12pF/250V; CAPC2012X95_SMD-0805
C3: 22pF/250V; CAPC2012X95_SMD-0805
C4: 0.75pF/100V; CAPC2012X95_SMD-0805
C5, C6, C11, C12, C17, C19, C21: 0.1uF/35V; CAPC2012X95_SMD-0805
C7, C8, C9, C10: 1uF/25V; CAPC2012X95_SMD-0805
C13, C18, C20, C22: 10uF/25V; CAPC2012X95_SMD-0805
C15, C16: 100uF/10V; CAPC3225X270_SMD-1210
D1, D2, D3, D4, D5, D7: 1A/50V; SODFL3516X170
D8: 150mA/75V; DFN100X60X55-2
FLEX1, FLEX2, FLEX3, FLEX4, FLEX5: 10K; _MOLEX-0530470210_VERT_PITCH-1.25MM
JP1: FTDI; FTDI_BASIC-6PIN-MALE-RA
L1, L2: 10uH; INDC2012X145
LED1: GREEN; LEDC2012X120_LED-0805
LIPO1: 7.4V; BATTERY_MOLEX-89401_RA_PITCH-2MM
MCU1: ATMEGA128RFA1; QFN50P900X900X90-64
Q1, Q2, Q3, Q4, Q5: SI2302CDS 2.9A/20V; SOT95P287X112-3
R1, R2, R3, R4, R5: 4.7K; RESC2012X60_SMD-0805
R6, R7, R8, R9, R10: 100; RESC2012X60_SMD-0805
R11, R12, R13, R14, R15, R16, R17: 10K; RESC2012X60_SMD-0805
SUPPLY38, SUPPLY39: 2PT_GND_TIE
SW1: 300mA/4V; SW_SLIDE_SPDT_RA_SMD_4V_300MA_6.7L-2.6W
VIBE1, VIBE2, VIBE3, VIBE4, VIBE5: Molex VERT 1.25mm pitch; _MOLEX-0530470210_VERT_PITCH-1.25MM
VREG-MCU: 1A/3.3V; SOIC127P600X265-8
VREG-VIBE: TL1963A-33 1.5A/3.3V; SOT229P700X180-4
Y1: 16 MHz; OSCCC500X320X110

Connections:
3.3V: C21.1, C22.1, D1.K, D2.K, D3.K, D4.K, D5.K, D7.A, VIBE1.1 (+), VIBE2.1 (+), VIBE3.1 (+), VIBE4.1 (+), VIBE5.1 (+), VREG-VIBE.3 (VO)
AGND: BALUN1.5 (GND), C3.1, C4.2, C8.1, C10.1, C11.1, L1.2, MCU1.7 (AVSS_RFP), MCU1.10 (AVSS_RFN), MCU1.58 (AVSS), MCU1.61 (AVSS), MCU1.EP (AVSS), MCU1.P$1 (AVSS), MCU1.P$2 (AVSS), MCU1.P$3 (AVSS), MCU1.P$4 (AVSS), MCU1.P$5 (AVSS), R1.2, R2.2, R3.2, R4.2, R5.2
AVCC: C10.2, C11.2, FLEX1.1 (+), FLEX2.1 (+), FLEX3.1 (+), FLEX4.1 (+), FLEX5.1 (+), L2.2, MCU1.59 (EVDD)
FLEX-INDEX: FLEX2.2 (-), MCU1.64 ((ADC1/A1*)PF1), R2.1
FLEX-MIDDLE: FLEX3.2 (-), MCU1.1 ((ADC2/DIG2/A2*)PF2), R3.1
FLEX-PINKY: FLEX5.2 (-), MCU1.3 ((ADC4/TCK/A4*)PF4), R5.1
FLEX-RING: FLEX4.2 (-), MCU1.2 ((ADC3/DIG4/A3*)PF3), R4.1
FLEX-THUMB: FLEX1.2 (-), MCU1.63 ((ADC0/A0*)PF0), R1.1
GND: AVR_ISP1.GND, C1.2, C2.2, C6.1, C7.1, C9.1, C12.2, C13.2, C15.2, C16.2, C17.2, C18.2, JP1.GND, LIPO1.-, MCU1.11 (TST), MCU1.20 (DVSS), MCU1.24 (DVSS), MCU1.33 (CLKI), MCU1.35 (DVSS), MCU1.45 (DVSS), MCU1.55 (DVSS), R11.1, R12.1, R13.1, R14.1, R15.1, R17.1, SUPPLY38.P$2, SUPPLY39.P$1, VREG-MCU.1 (GND), VREG-MCU.2 (!EN)
INDEX-VIBE: MCU1.50 ((INT4/OC3B/D4-PWM4)PE4), R7.1
MIDDLE-VIBE: MCU1.51 ((INT5/OC3C/D5-PWM5)PE5), R8.1
MISO: AVR_ISP1.MISO, MCU1.39 ((PDO/PCINT3/MISO/D12)PB3)
MOSI: AVR_ISP1.MOSI, MCU1.38 ((PDI/PCINT2/MOSI/D11)PB2)
unnamed: D1.A, Q1.3 (D), VIBE1.2 (-)
unnamed: D2.A, Q2.3 (D), VIBE2.2 (-)
unnamed: D3.A, Q3.3 (D), VIBE3.2 (-)
unnamed: D4.A, Q4.3 (D), VIBE4.2 (-)
unnamed: D5.A, Q5.3 (D), VIBE5.2 (-)
unnamed: C2.1, MCU1.56 (XTAL2), Y1.1 (XTAL1)
unnamed: C1.1, MCU1.57 (XTAL1), Y1.3 (XTAL2)
unnamed: BALUN1.2 (GND), C3.2
unnamed: ANT1.1, BALUN1.1 (IN), C4.1
unnamed: BALUN1.3 (OUT1), MCU1.9 (RFN)
unnamed: BALUN1.4 (OUT2), MCU1.8 (RFP)
unnamed: C5.1, JP1.DTR
unnamed: Q2.1 (G), R6.2, R11.2
unnamed: LIPO1.+, SW1.2
unnamed: Q1.1 (G), R7.2, R12.2
unnamed: Q3.1 (G), R8.2, R13.2
unnamed: L1.1, SUPPLY39.P$2
unnamed: Q4.1 (G), R9.2, R14.2
unnamed: C8.2, MCU1.60 (AVDD)
unnamed: Q5.1 (G), R10.2, R15.2
unnamed: C9.2, MCU1.21 (DVDD), MCU1.22 (DVDD)
unnamed: LED1.K, R17.2
NGND: C19.2, C20.2, C21.2, C22.2, Q1.2 (S), Q2.2 (S), Q3.2 (S), Q4.2 (S), Q5.2 (S), SUPPLY38.P$1, VREG-VIBE.2 (GND), VREG-VIBE.4 (GND)
PINKY-VIBE: MCU1.41 ((PCINT5/OC1A/D8-PWM8)PB5), R10.1
RESET: AVR_ISP1.RESET, C5.2, D8.A, MCU1.12 (RSTN), R16.2
RING-VIBE: MCU1.40 ((PCINT4/OC2A/D9-PWM9)PB4), R9.1
RXO: JP1.TXO, MCU1.46 ((PCINT8/RXD0/D0)PE0)
SCK: AVR_ISP1.SCK, MCU1.37 ((PCINT1/SCK/D13)PB1)
THUMB-VIBE: MCU1.49 ((AIN1/OC3A/D3-PWM3)PE3), R6.1
TXO: JP1.RXI, MCU1.47 ((TXD0/D1)PE1)
VBAT: C12.1, C13.1, C15.1, C16.1, C19.1, C20.1, D7.K, LED1.A, SW1.1 (S1), VREG-MCU.3 (VIN), VREG-MCU.4 (VIN), VREG-VIBE.1 (VI)
VCC: C6.2, C7.2, C17.1, C18.1, D8.K, L2.1, MCU1.23 (DEVDD), MCU1.34 (DEVDD), MCU1.44 (DEVDD), MCU1.54 (DEVDD), R16.1, VREG-MCU.5 (VOUT), VREG-MCU.6 (VOUT)

Notes on the sheet:
Flex Sensors
Programming ICs
Vibe Motors
ATMEGA128RFA1
Power Supply

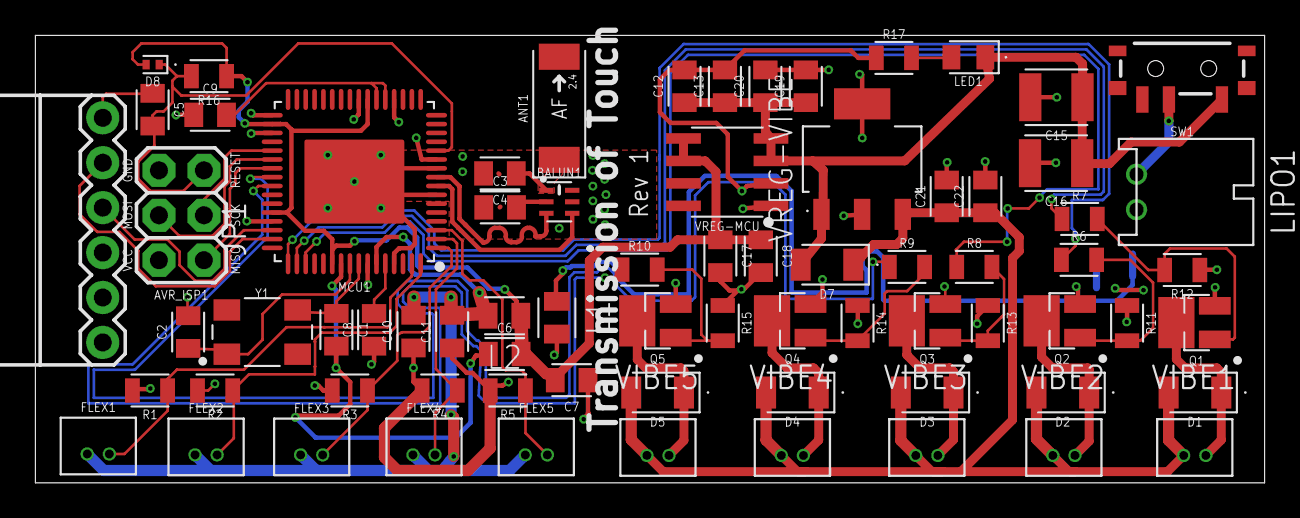
[picture p14: board TouchGlove.brd from above]

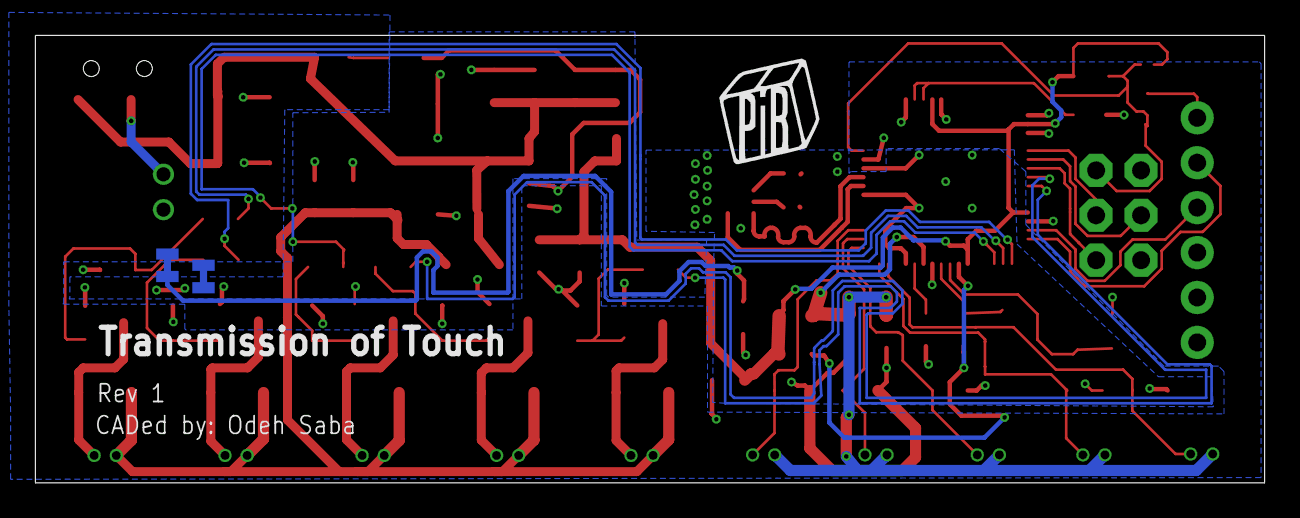
[picture p15: board TouchGlove.brd from below]

Board: 2 copper layers, 69.5 x 25.3 mm, 76 parts (3 on the bottom side), 45 nets.

Other parts of the board:
U$1: PIB_LOGO_10MM
