odeh24/SRIP-ToT/(commit log)

2018-07-10 Add unified TouchGlove and Robotic Arm code
2018-07-10 The vibe motors work well!
2018-07-11 Now with the Eagle Schematic
    [FlexSensor and Servo.sch]
2018-07-11 Eagle folder added and named so
    [FlexSensor and Servo.sch]
2018-07-11 Reorganizeing directories and files
    [FlexSensor and Servo.sch]
2018-07-13 Update to eagle schematics, barebones of glove and arm board schematics complete
    [PressureSensors.sch, RobotArm.sch, TouchGlove.sch, VibeMotors.sch]
2018-07-19 Updated RobotArm Schematic
    [RobotArm.brd, RobotArm.sch]
2018-07-19 Added so many capacitors it's not even funny
    [RobotArm.sch]
2018-07-31 I routed everything except for VCC. I am not sure how to proceed from here.
    [RobotArm.brd, RobotArm.sch]
2018-08-01 last update
    [RobotArm.brd, RobotArm.sch]
2018-08-01 Massaged around some stuff.
    [RobotArm.brd, RobotArm.sch]
2018-08-02 Adding finished touch glove schematic and pcb board
    [FlexSensor and Servo.sch, PressureSensors.sch, RobotArm.sch, TouchGlove.brd, TouchGlove.sch, VibeMotors.sch]
2018-08-03 Fixing DRC errors in touchglove brd
    [TouchGlove.brd]
2018-08-03 Hopefully not too much to change
    [RobotArm.brd]
2018-08-03 jesus help me
    [RobotArm.brd]
2018-08-03 Rotated that shitty chip.
    [TouchGlove.brd, TouchGlove.sch]
2018-08-03 Create antenna CKTry.
    [RobotArm.brd, RobotArm.sch]
2018-08-03 thank you so much Colin!
    [RobotArm.brd]
2018-08-03 Fixing very large amount of bugs in touch glove schematic
    [TouchGlove.brd]
2018-08-03 Please check changes and order this piece
    [RobotArm.brd]
2018-08-07 attempt at update
    [FlexSensor and Servo.sch, PressureSensors.sch, RobotArm.brd, RobotArm.sch, TouchGlove.sch, VibeMotors.sch]
2018-08-07 deleted arm schematic
    [RobotArm.sch]
2018-08-07 Reorganized eagle into one folder
    [FlexSensor and Servo.sch, PressureSensors.sch, RobotArm.brd, RobotArm.sch, TouchGlove.sch, VibeMotors.sch]
2018-08-08 Revert to 8e7366f when I asked Colin to order
    [FlexSensor and Servo.sch, PressureSensors.sch, RobotArm.brd, RobotArm.sch, TouchGlove.sch, VibeMotors.sch]
2018-08-08 Rev 1: Ready for fab.
    [TouchGlove v2.step, TouchGlove.brd, TouchGlove.sch]
2018-08-09 ruh roh.....
    [TouchGlove v2.step]
